Oxjade/Circuit/README.md

# Circuit

Standalone touchscreen hardware wallet built on Ika dWallet / 2PC-MPC signing.

## Status

| Phase | State |
|---|---|
| 1 — Hardware architecture | Draft for review: [docs/phase1/hardware-architecture.md](docs/phase1/hardware-architecture.md), [placement concept](docs/phase1/placement-concept.svg) |
| 2 — Industrial design | First-pass FreeCAD model, 60 x 94 x 12.3 mm, no interferences: [mechanical/README.md](mechanical/README.md) |
| 3 — Component selection | MCU decided: STM32U5G9 (hybrid architecture accepted). Other parts proposed, pending datasheet verification |
| 4 — Electrical | Complete draft schematic, nine sheets, 127 parts: [kicad/README.md](kicad/README.md). Not reviewed; ten open items listed there |
| 5 — PCB | Provisional board outline only. No placement, no routing |
| 6–8 | Not started |

## Open gates

- **G1 (no longer blocking):** measure Ika user-side ECDSA sign on the STM32U5G9 dev kit. Decides whether the ECDSA user share can later move onto the device.
- **Datasheet pass:** component figures in Phase 1 came from search extracts, not from opened datasheets.
