Oxjade/Circuit/kicad/board-definition-preview.png

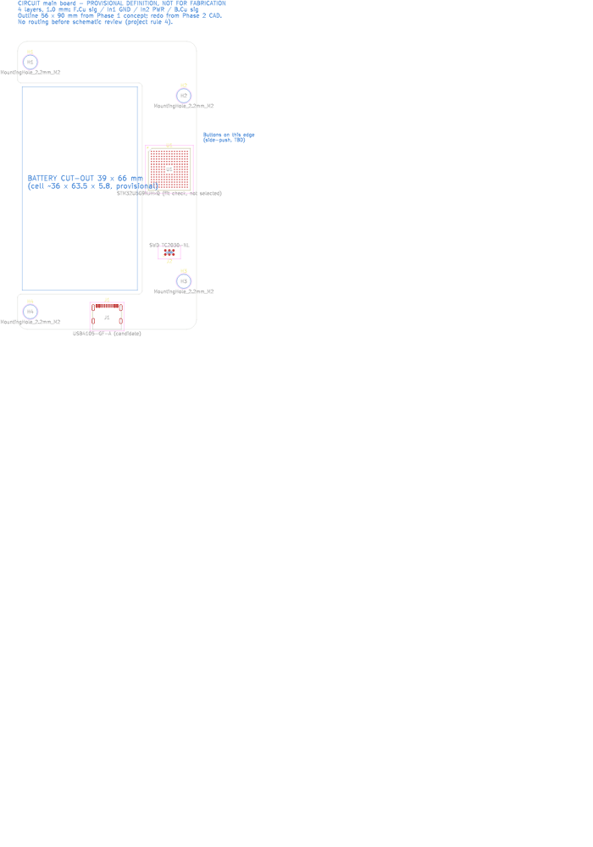
kicad/board-definition-preview.png
