Oxjade/Circuit/mechanical/renders/bottom-usb.png

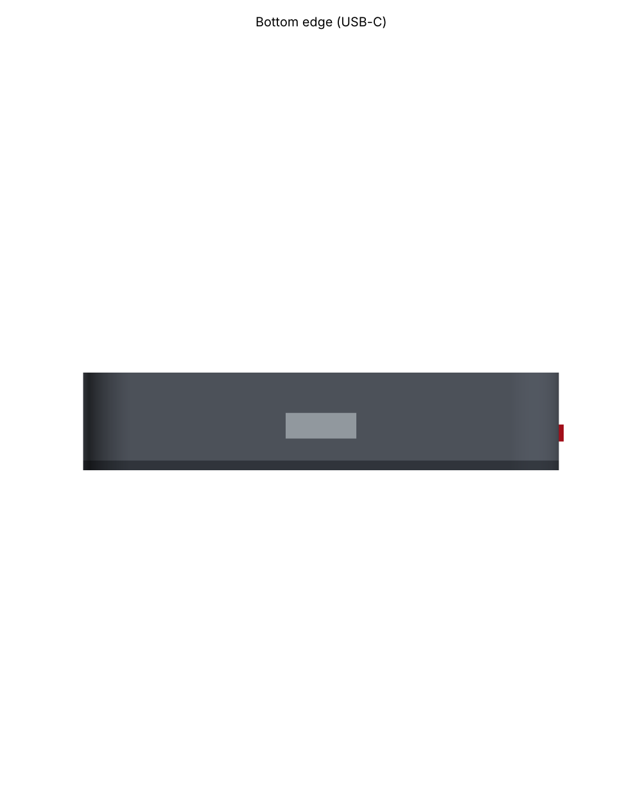
mechanical/renders/bottom-usb.png
