Oxjade/Circuit/mechanical/renders/exploded.png

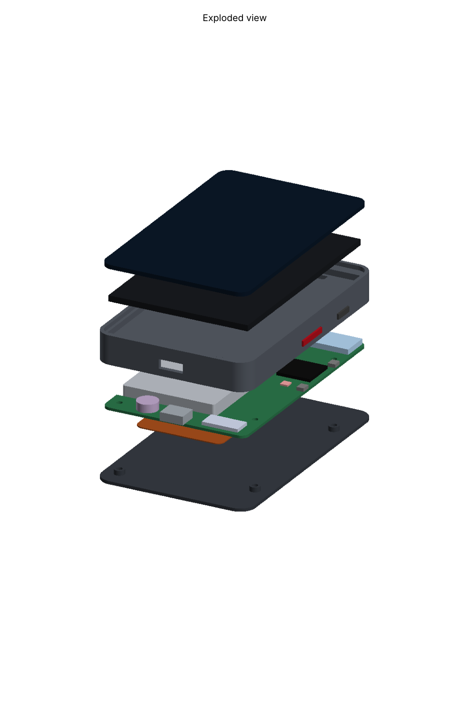
mechanical/renders/exploded.png
