Oxjade/Circuit/mechanical/renders/front-iso.png

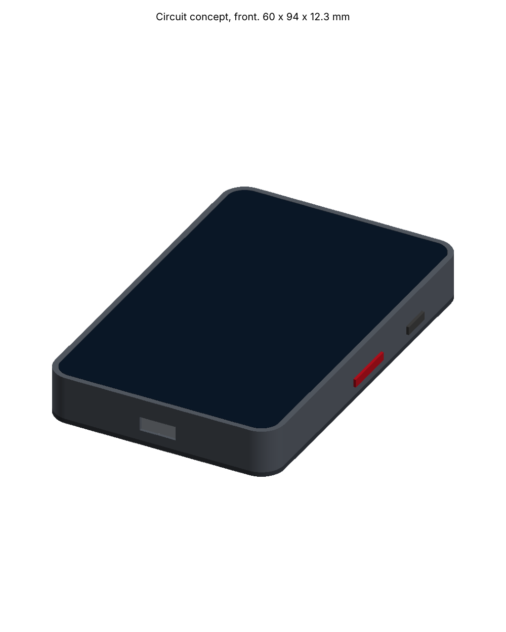
mechanical/renders/front-iso.png
