Oxjade/Circuit/mechanical/renders/front.png

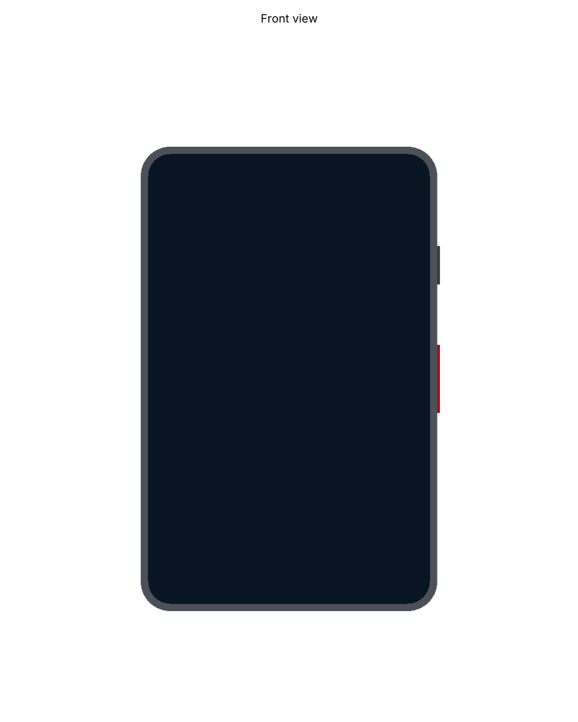
mechanical/renders/front.png
