Oxjade/Circuit/mechanical/renders/internal-from-front.png

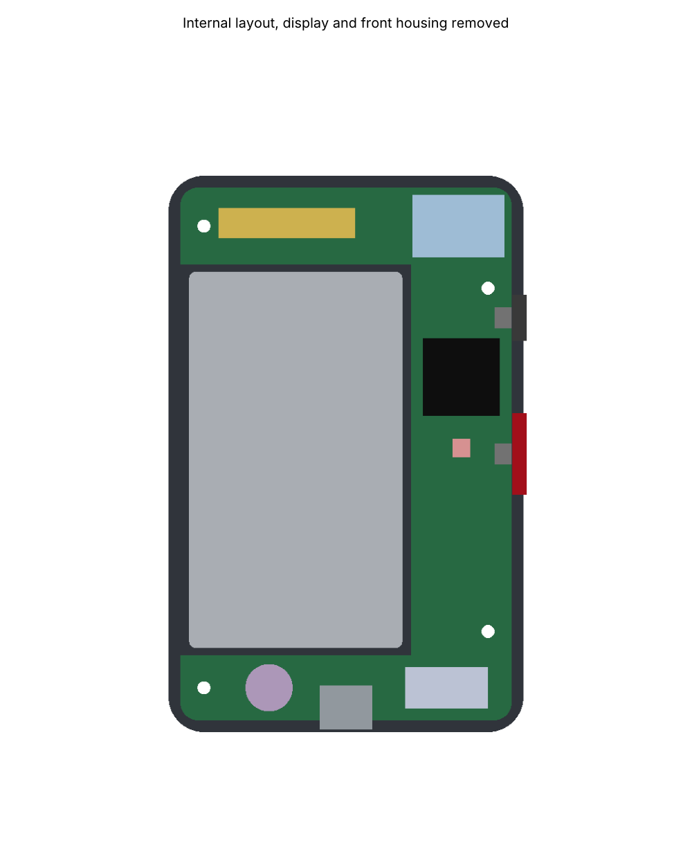
mechanical/renders/internal-from-front.png
