Oxjade/Circuit/mechanical/renders/rear-iso.png

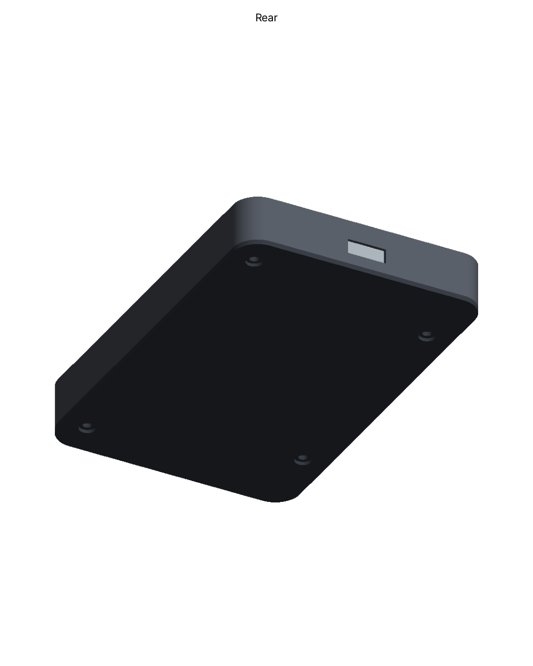
mechanical/renders/rear-iso.png
