Oxjade/Circuit/mechanical/renders/right-buttons.png

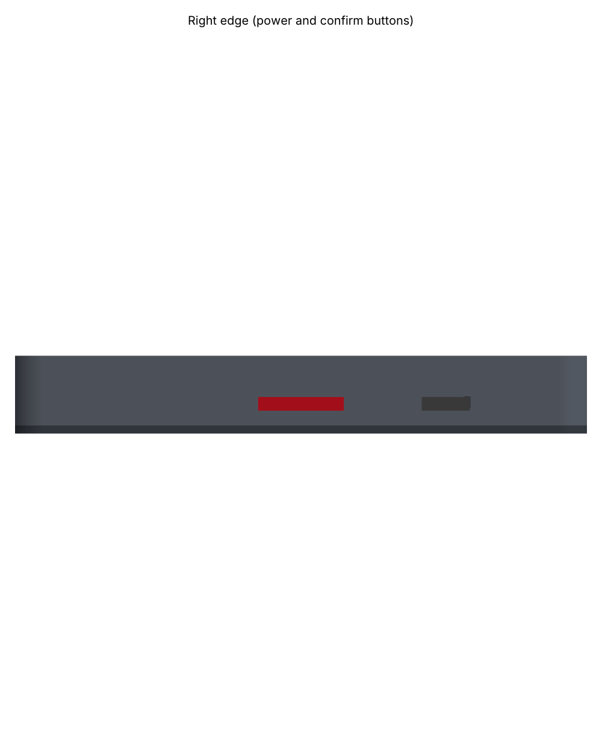
mechanical/renders/right-buttons.png
