Oxjade/Circuit/kicad/bom-draft.csv

Qty | References | Value | Footprint
2 | C1 C40 | 1uF 25V | Capacitor_SMD:C_0603_1608Metric
7 | C2 C3 C35 C48 C50 C58 C61 | 1uF | Capacitor_SMD:C_0402_1005Metric
24 | C4 C5 C10 C11 C12 C13 C14 C15 C16 C17 C18 C19 C24 C25 C26 C28 C36 C37 C38 C43 C51 C52 C54 C57 | 100nF | Capacitor_SMD:C_0402_1005Metric
4 | C20 C21 C22 C34 | 2.2uF (TBD) | Capacitor_SMD:C_0402_1005Metric
6 | C23 C27 C44 C45 C46 C53 | 10uF | Capacitor_SMD:C_0603_1608Metric
1 | C29 | 100nF (TBD) | Capacitor_SMD:C_0402_1005Metric
4 | C30 C31 C32 C33 | CL (TBD) | Capacitor_SMD:C_0402_1005Metric
3 | C41 C42 C55 | 4.7uF | Capacitor_SMD:C_0603_1608Metric
2 | C47 C49 | 1nF (TBD) | Capacitor_SMD:C_0402_1005Metric
1 | C56 | DNP (tune) | Capacitor_SMD:C_0402_1005Metric
1 | C59 | 1uF 50V | Capacitor_SMD:C_0603_1608Metric
1 | C60 | 220nF | Capacitor_SMD:C_0402_1005Metric
2 | D1 D2 | ESD 0402 (TBD)
1 | D3 | 40V 0.5A | Diode_SMD:D_SOD-123
1 | FB1 | 600R@100MHz | Inductor_SMD:L_0402_1005Metric
1 | J1 | USB4105-GF-A (candidate) | Connector_USB:USB_C_Receptacle_GCT_USB4105-xx-A_16P_TopMnt_Horizontal
1 | J2 | SWD TC2030-NL | Connector:Tag-Connect_TC2030-IDC-NL_2x03_P1.27mm_Vertical
1 | J3 | LRA pads
1 | J4 | Li-Po JST-PH | Connector_JST:JST_PH_S2B-PH-SM4-TB_1x02-1MP_P2.00mm_Horizontal
1 | J5 | BLE SWD TC2030-NL | Connector:Tag-Connect_TC2030-IDC-NL_2x03_P1.27mm_Vertical
1 | J6 | NFC coil pads
1 | J7 | LCD FPC 40P 0.5mm (PINOUT TBD) | Connector_FFC-FPC:Hirose_FH12-40S-0.5SH_1x40-1MP_P0.50mm_Horizontal
1 | J8 | Touch FPC 6P 0.5mm (PINOUT TBD) | Connector_FFC-FPC:Hirose_FH12-6S-0.5SH_1x06-1MP_P0.50mm_Horizontal
2 | J9 J10 | case switch pads
1 | L1 | 2.2uH (TBD) | Inductor_SMD:L_0805_2012Metric
1 | L2 | 2.2uH 1.5A | Inductor_SMD:L_1008_2520Metric
1 | L3 | 10uH 0.5A | Inductor_SMD:L_1008_2520Metric
2 | R1 R2 | 5.1k 1% | Resistor_SMD:R_0402_1005Metric
1 | R3 | 0R (TBD) | Resistor_SMD:R_0402_1005Metric
11 | R4 R5 R8 R34 R35 R36 R37 R39 R40 R45 R47 | 100k | Resistor_SMD:R_0402_1005Metric
2 | R6 R9 | 1k | Resistor_SMD:R_0402_1005Metric
2 | R10 R11 | 1M | Resistor_SMD:R_0402_1005Metric
1 | R20 | 0R (TBD, see note 2) | Resistor_SMD:R_0402_1005Metric
2 | R21 R33 | 0R | Resistor_SMD:R_0402_1005Metric
5 | R22 R43 R44 R48 R49 | 10k | Resistor_SMD:R_0402_1005Metric
6 | R23 R24 R25 R26 R27 R28 | 2.2k | Resistor_SMD:R_0402_1005Metric
1 | R30 | 1.78k 1% | Resistor_SMD:R_0402_1005Metric
1 | R31 | 1.6k 1% | Resistor_SMD:R_0402_1005Metric
1 | R32 | 10k 1% | Resistor_SMD:R_0402_1005Metric
1 | R38 | 100R | Resistor_SMD:R_0402_1005Metric
2 | R41 R42 | 1M 1% | Resistor_SMD:R_0402_1005Metric
1 | R46 | 10R 1% | Resistor_SMD:R_0402_1005Metric
1 | SW1 | CONFIRM
1 | SW2 | POWER
1 | U1 | STM32U5G9NJH6Q | Package_BGA:TFBGA-216_13x13mm_Layout15x15_P0.8mm
1 | U2 | USBLC6-2SC6 | Package_TO_SOT_SMD:SOT-23-6
1 | U3 | DRV2605LDGS | Package_SO:VSSOP-10_3x3mm_P0.5mm
1 | U4 | BQ24075RGT | Package_DFN_QFN:VQFN-16-1EP_3x3mm_P0.5mm_EP1.6x1.6mm
1 | U5 | TPS63001 | Package_SON:Texas_DRC0010J_ThermalVias
2 | U6 U7 | TPS22917DBV | Package_TO_SOT_SMD:SOT-23-6
1 | U8 | OPTIGA Trust M V3 | Package_DFN_QFN:DFN-10-1EP_3x3mm_P0.5mm_EP1.55x2.48mm
1 | U9 | MDBT50Q-1MV2 | RF_Module:Raytac_MDBT50Q
1 | U10 | ST25DV04K-IER8C3 | Package_DFN_QFN:DFN-8-1EP_3x2mm_P0.5mm_EP1.36x1.46mm
1 | U11 | TPS61165DBV | Package_TO_SOT_SMD:SOT-23-6
1 | Y1 | 16MHz | Crystal:Crystal_SMD_2016-4Pin_2.0x1.6mm
1 | Y2 | 32.768kHz | Crystal:Crystal_SMD_3215-2Pin_3.2x1.5mm
