Oxjade/Circuit/mechanical/circuit-assembly.step

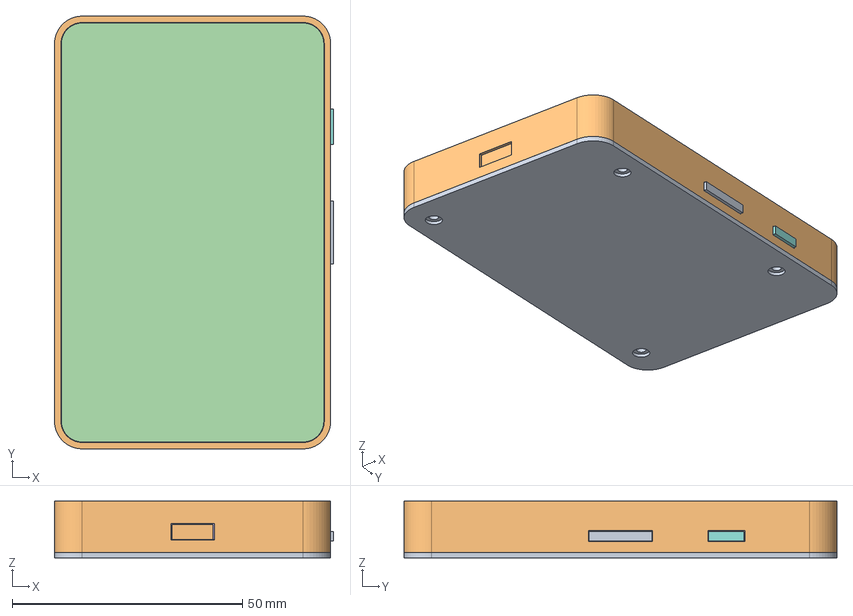
[picture p9: CAD file, 2026-11-11]
mechanical/circuit-assembly.step
60.6 x 94.0 x 12.3 mm
