Oxjade/Circuit/mechanical/rear_cover.stl

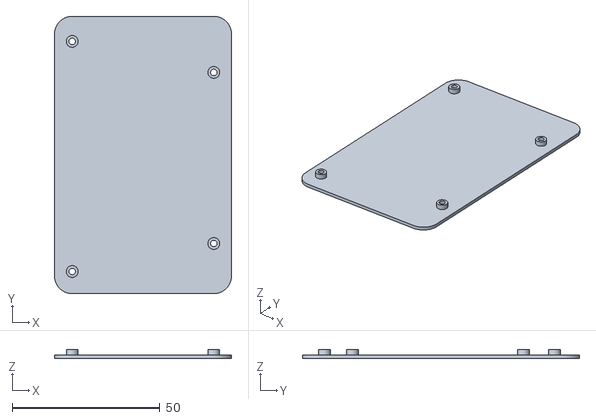
[picture p10: CAD file, 2026-11-11]
mechanical/rear_cover.stl
60.0 x 94.0 x 3.00
