Oxjade/Circuit/mechanical/button_power.stl

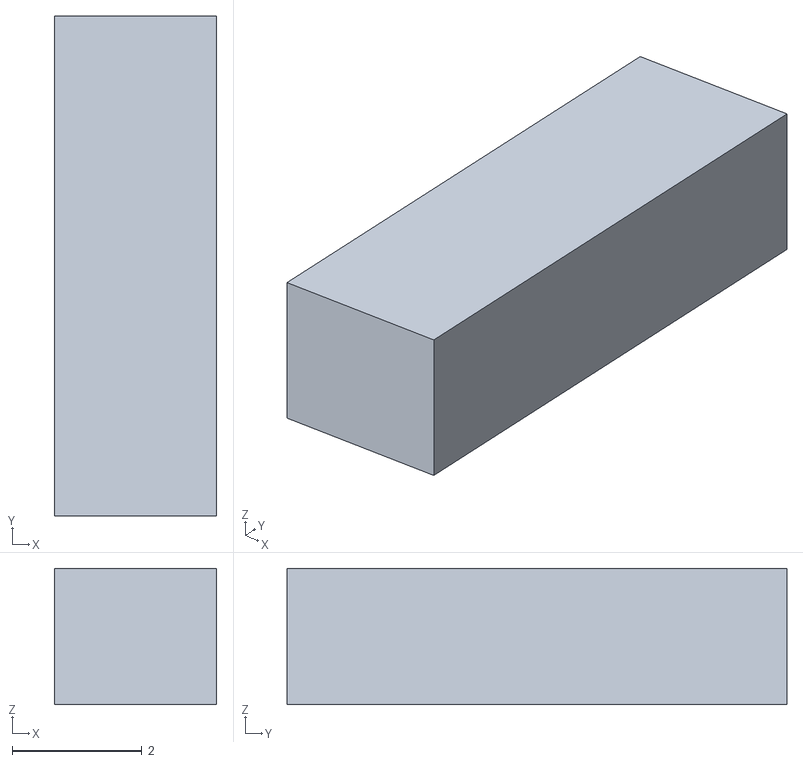
[picture p11: CAD file, 2026-11-11]
mechanical/button_power.stl
2.50 x 7.70 x 2.10
