Oxjade/Circuit/mechanical/button_confirm.stl

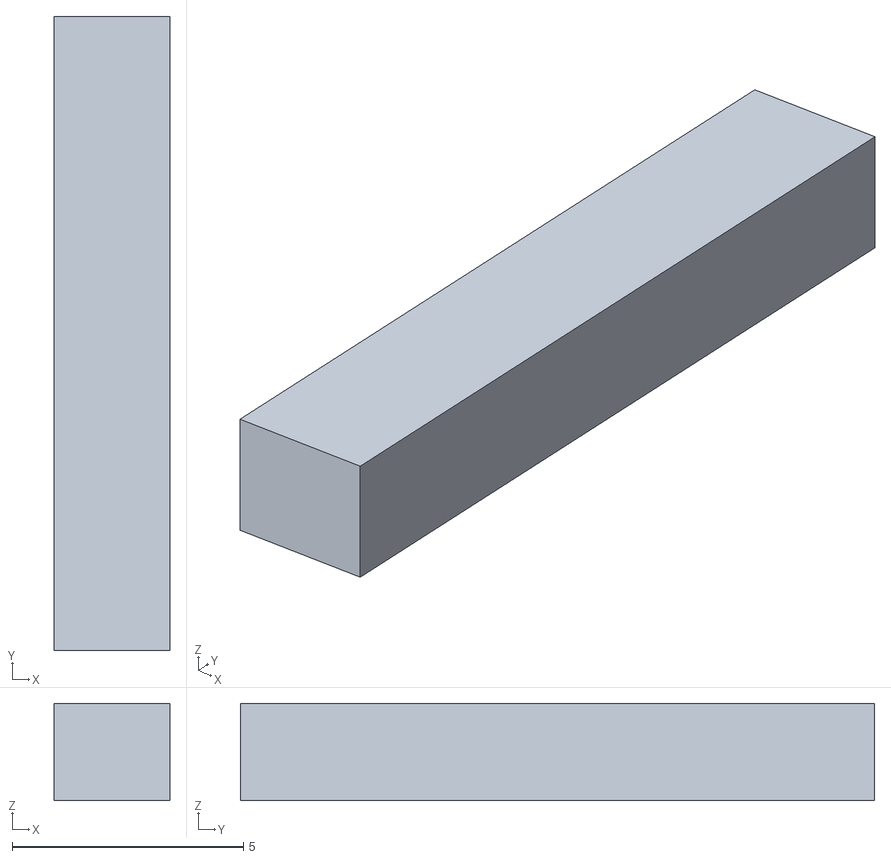
[picture p12: CAD file, 2026-11-11]
mechanical/button_confirm.stl
2.50 x 13.7 x 2.10
