Oxjade/Circuit/mechanical/front_housing.stl

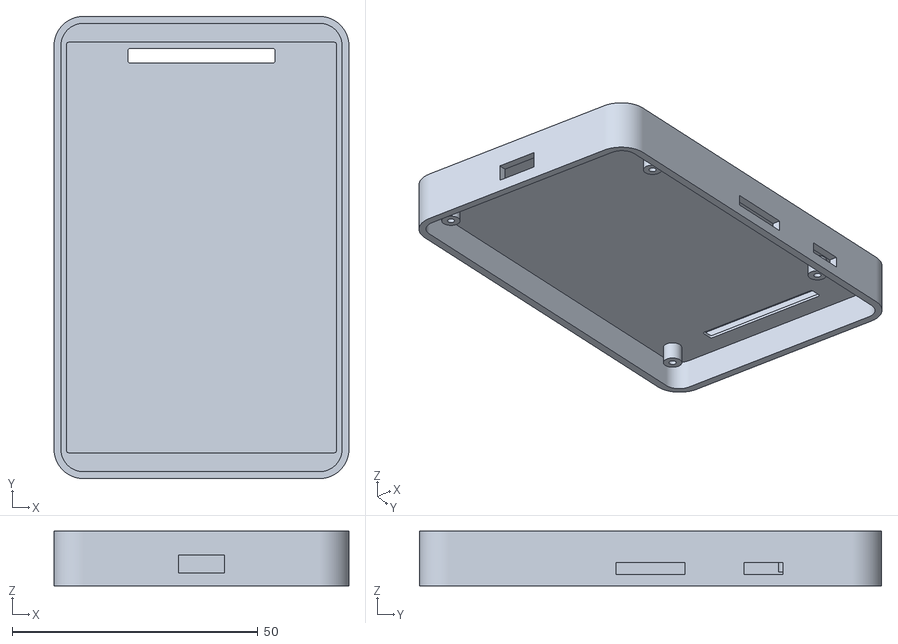
[picture p13: CAD file, 2026-11-11]
mechanical/front_housing.stl
60.0 x 94.0 x 11.1
