Oxjade/Circuit/(list of files, cad)

Other CAD files:
mechanical/circuit.FCStd
