Oxjade/Circuit/kicad/schematic-draft.pdf

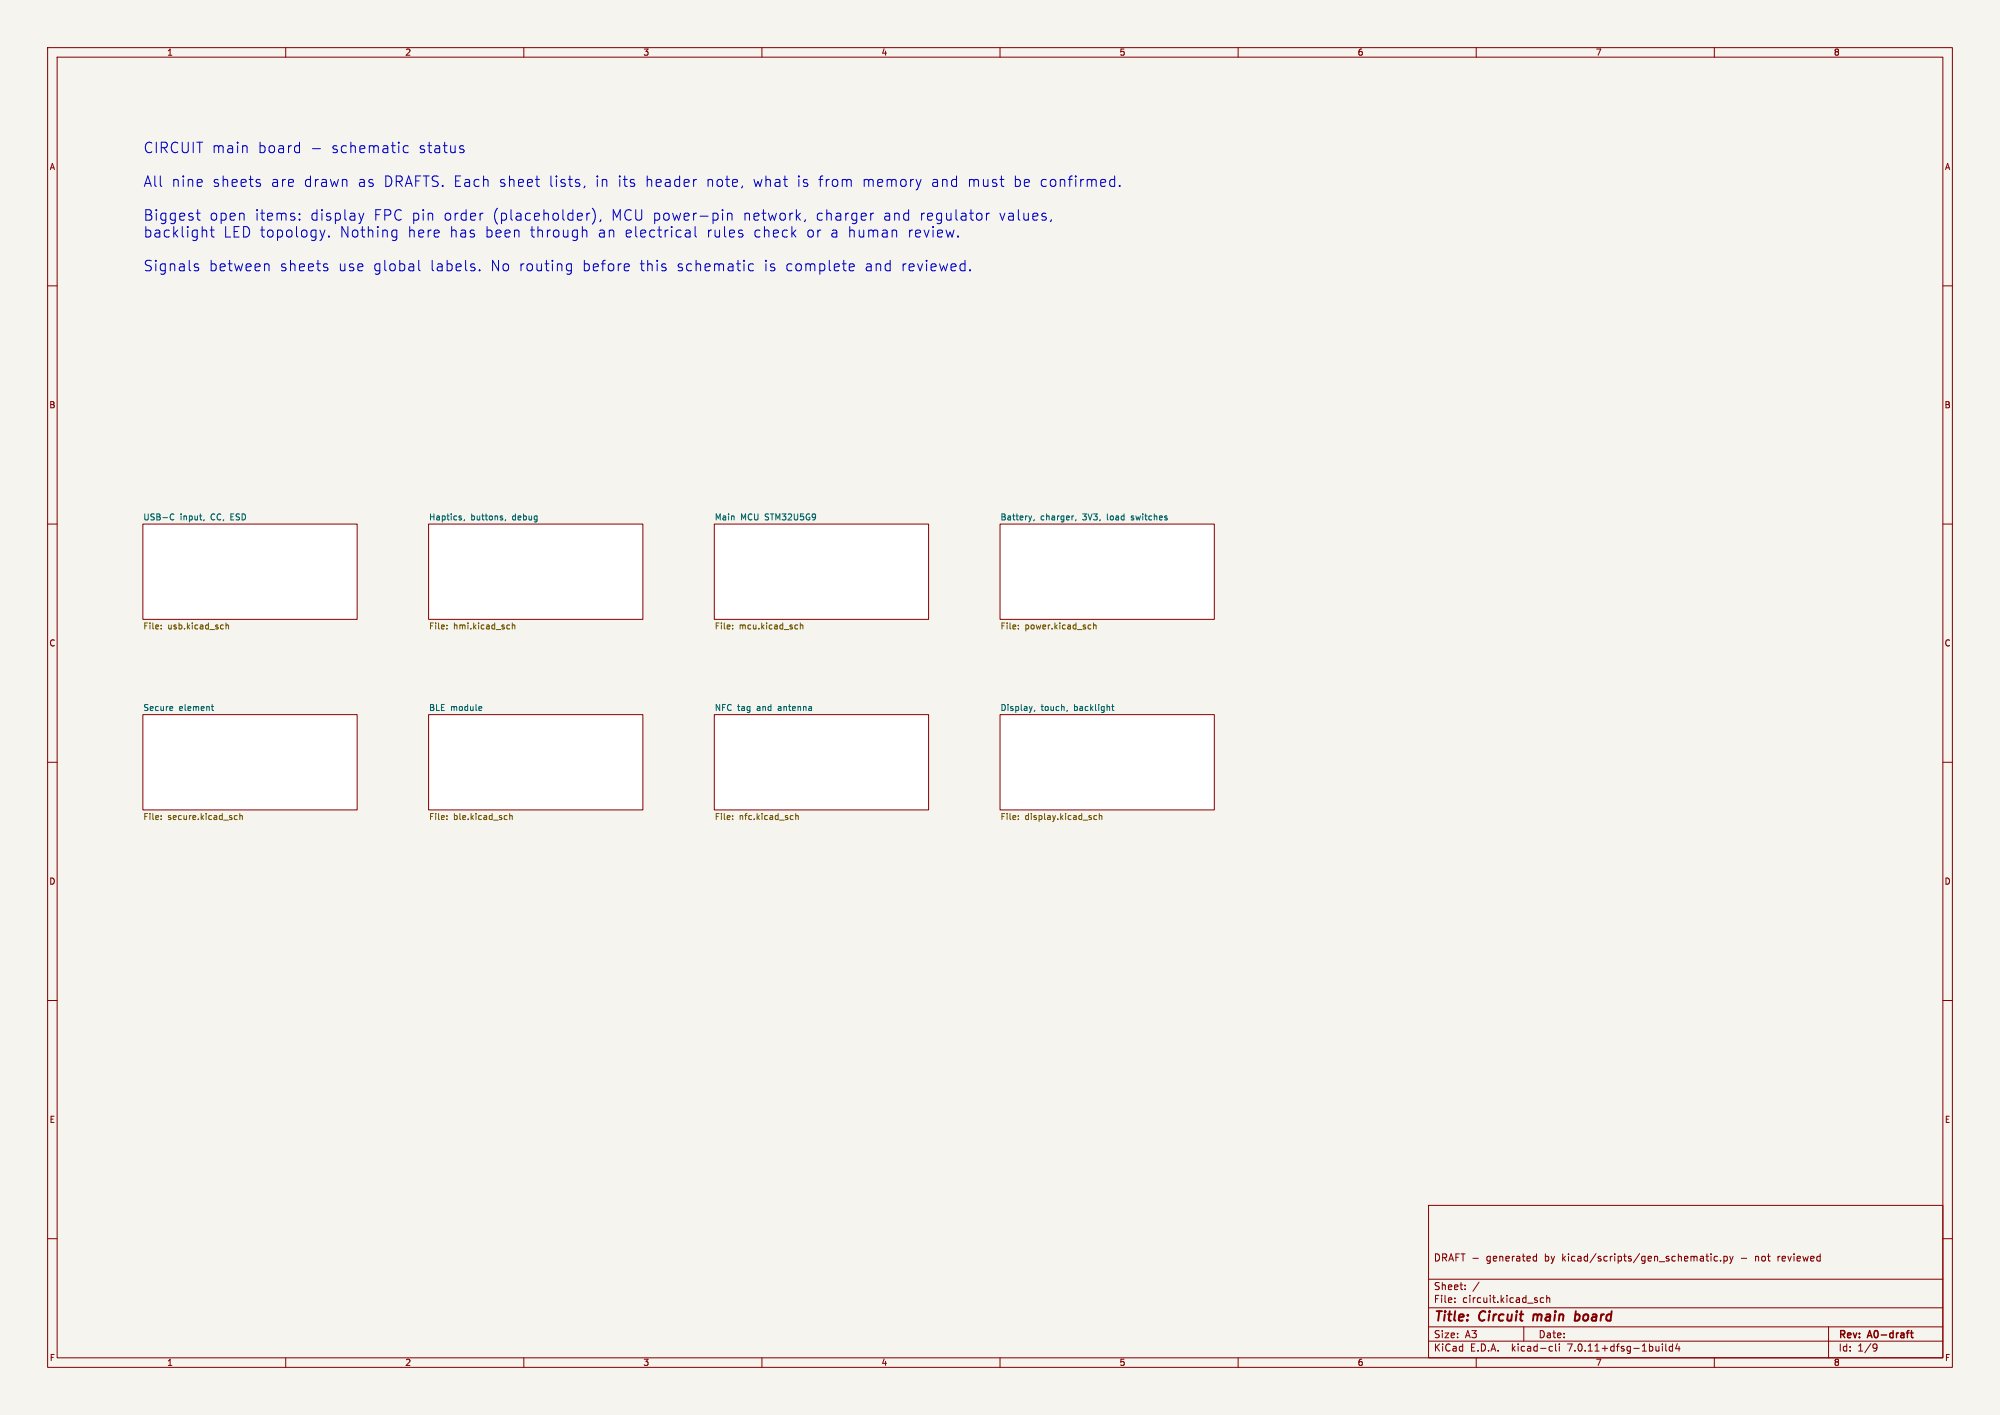
[picture p14: page 1]

Id: 1/9 Title: Circuit main board

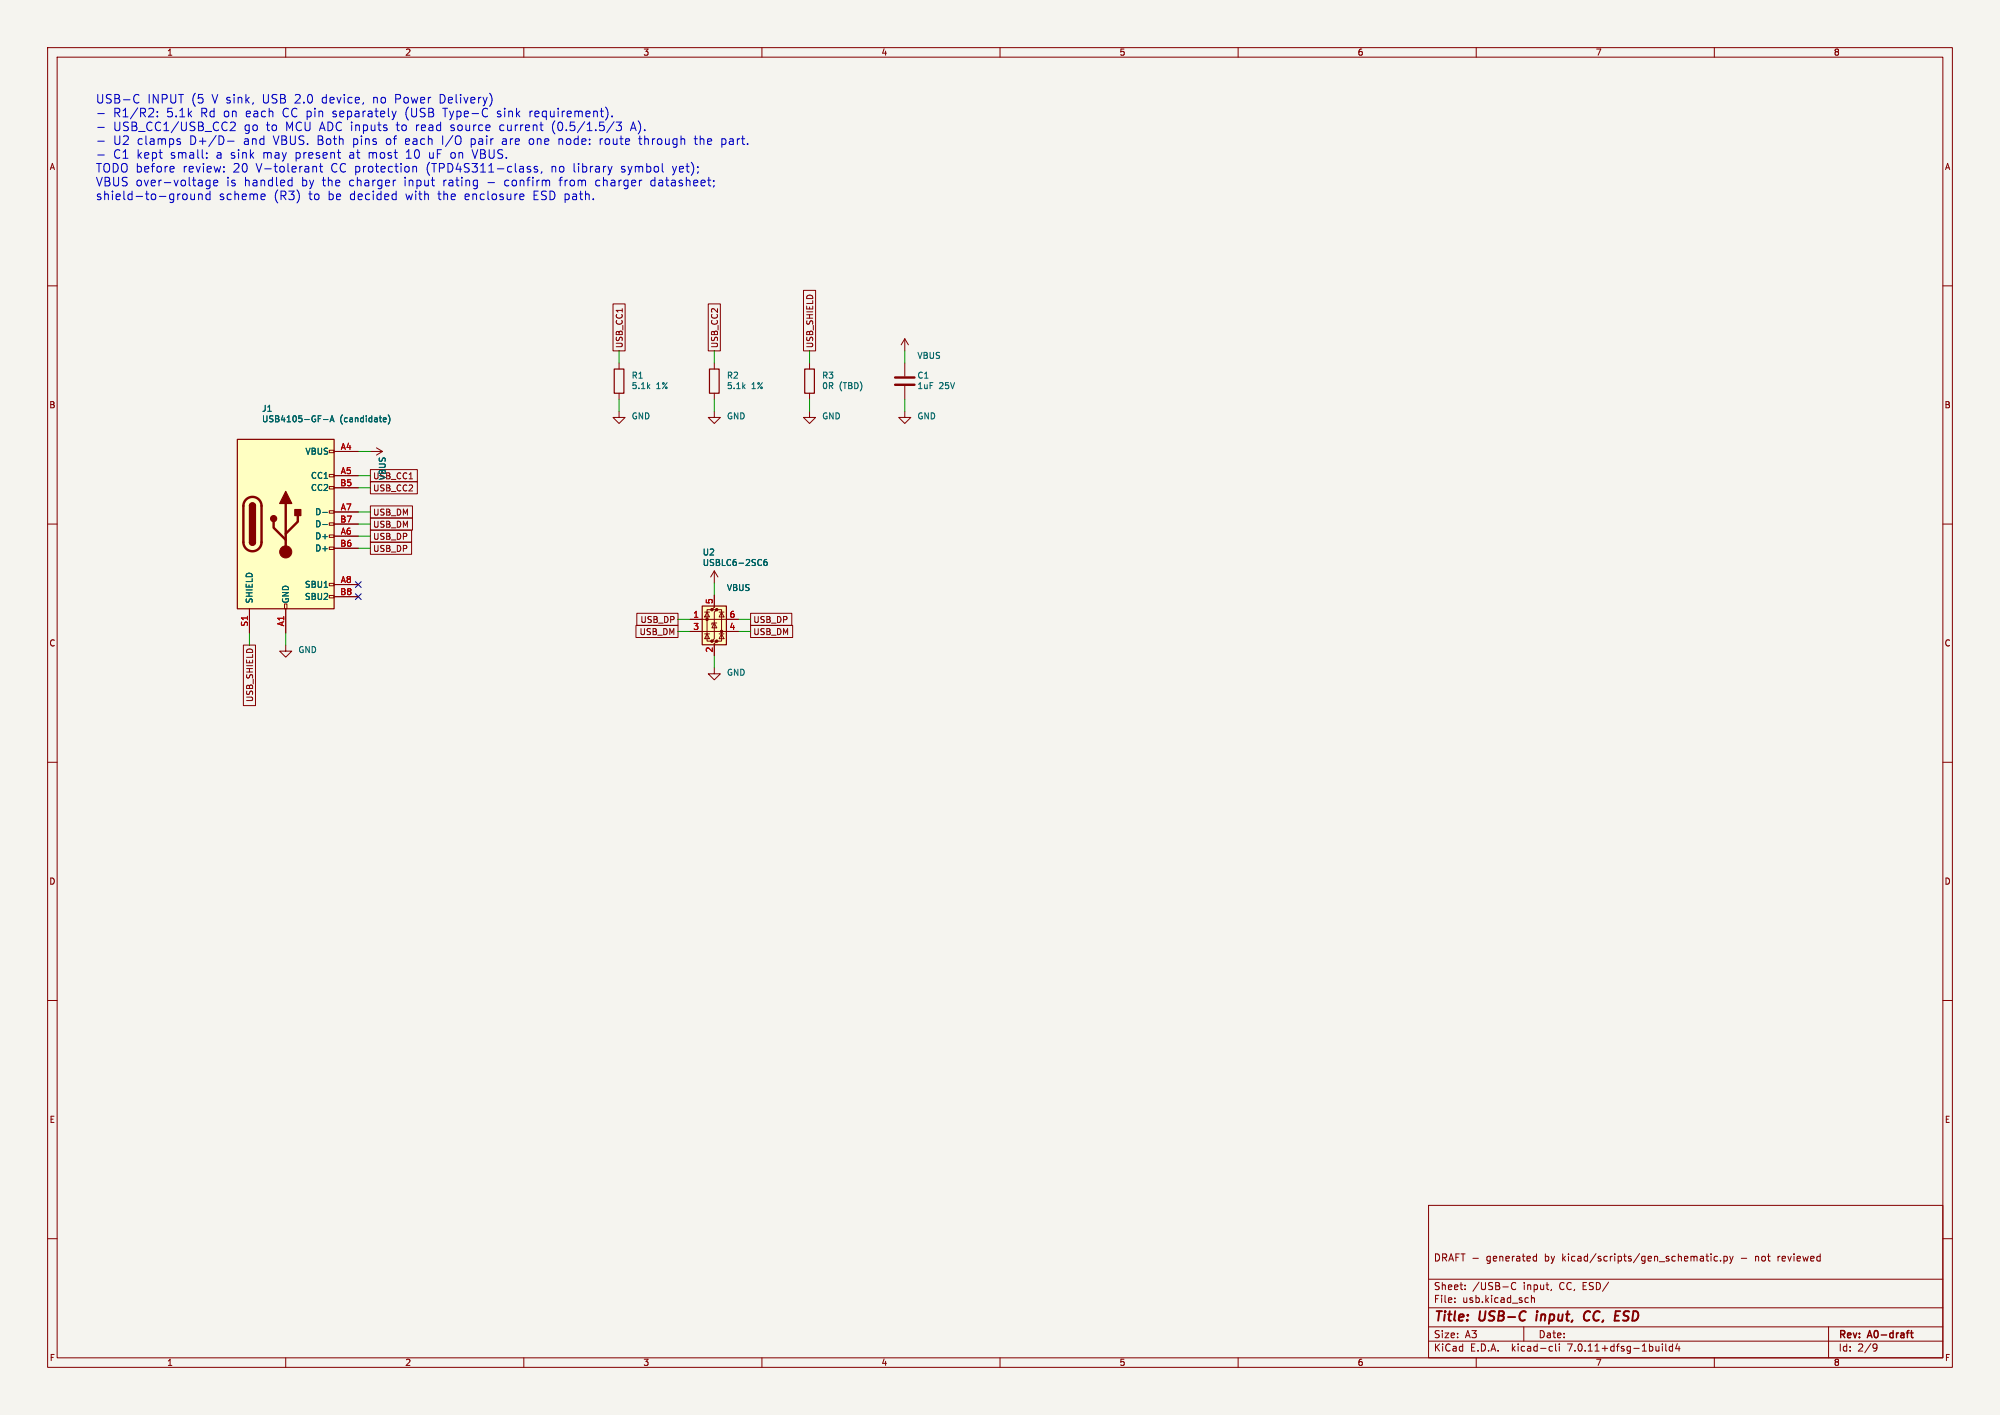
[picture p15: page 2]

Id: 2/9 Title: USB-C input, CC, ESD

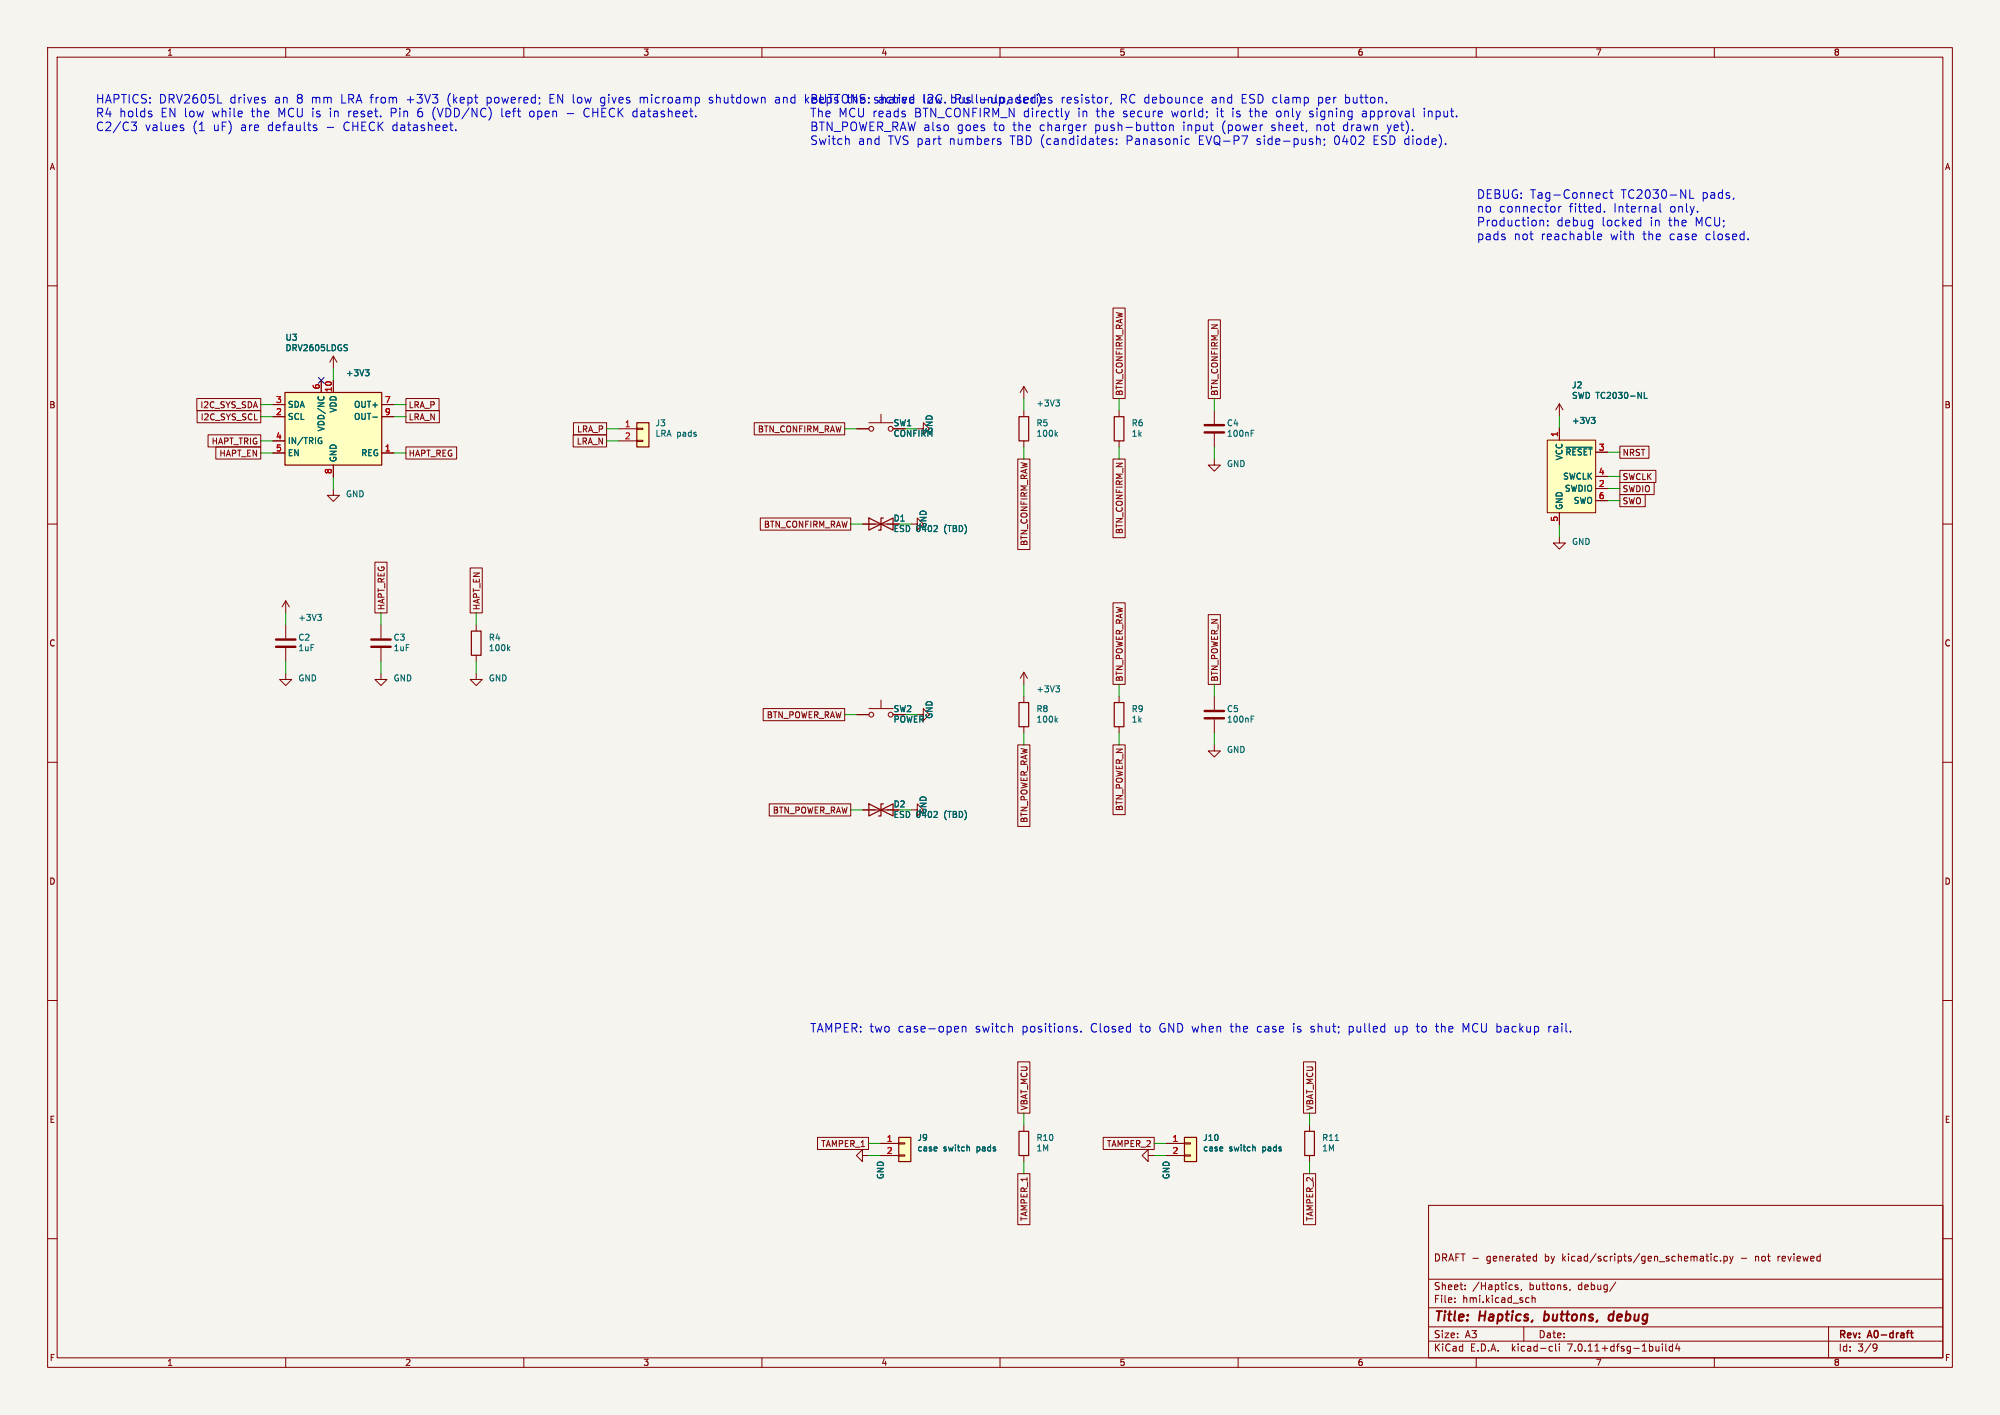
[picture p16: page 3]

R4 holds EN low while the MCU is in reset. Pin 6 (VDD/NC) left open - CHECK datasheet.

1 SWDIO 2 ~{RESET}3 SWCLK 4 GND

Id: 3/9 Title: Haptics, buttons, debug

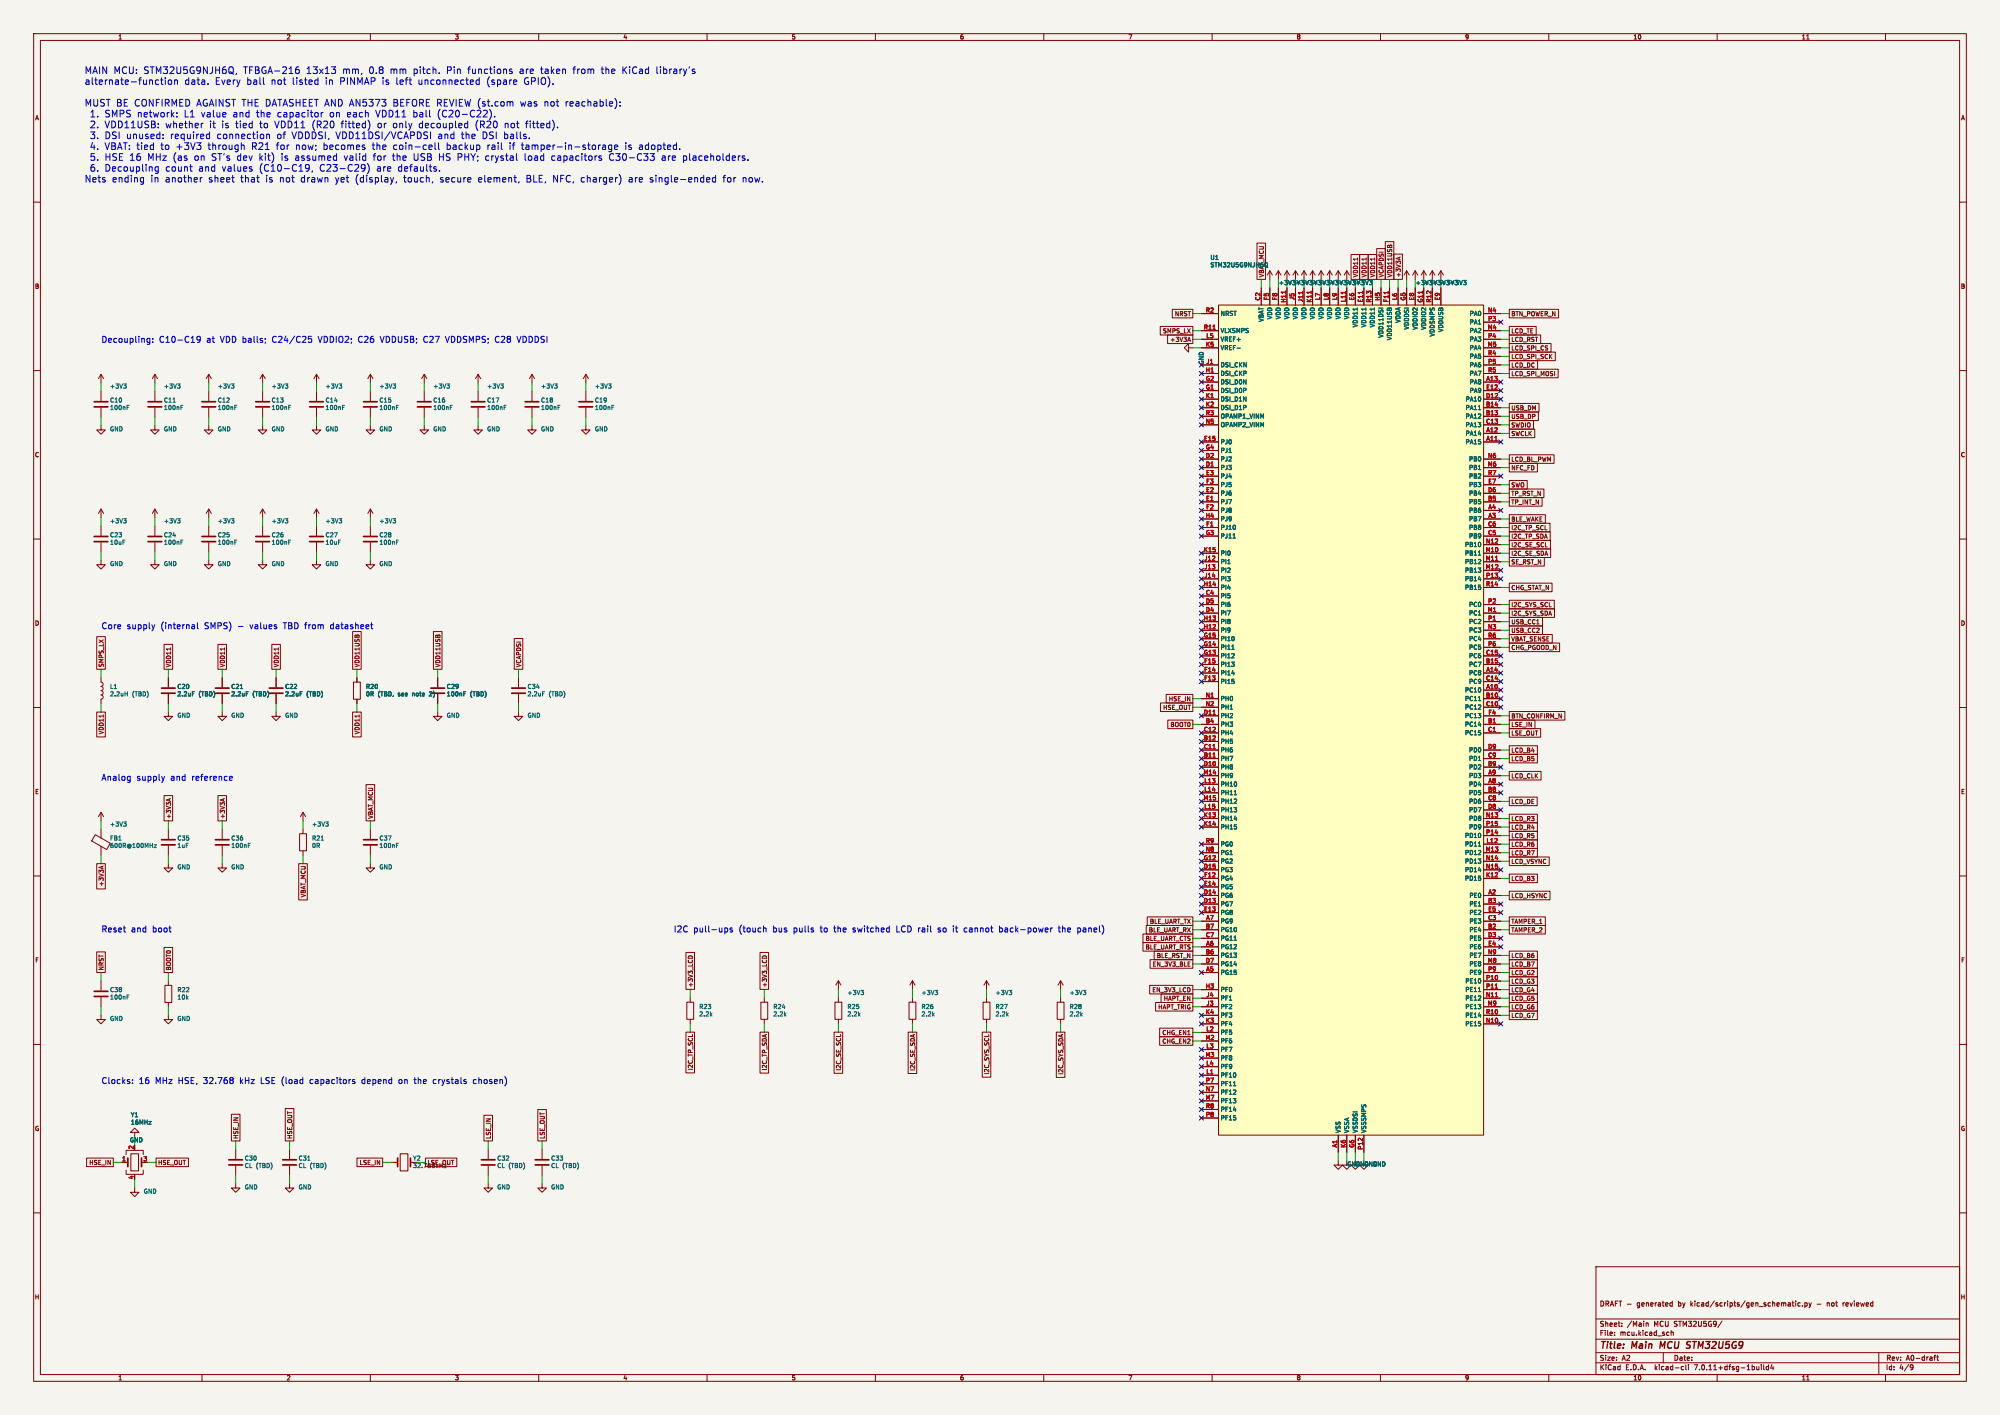
[picture p17: page 4]

MUST BE CONFIRMED AGAINST THE DATASHEET AND AN5373 BEFORE REVIEW (st.com was not reachable):

VBAT_SENSE Analog supply and reference

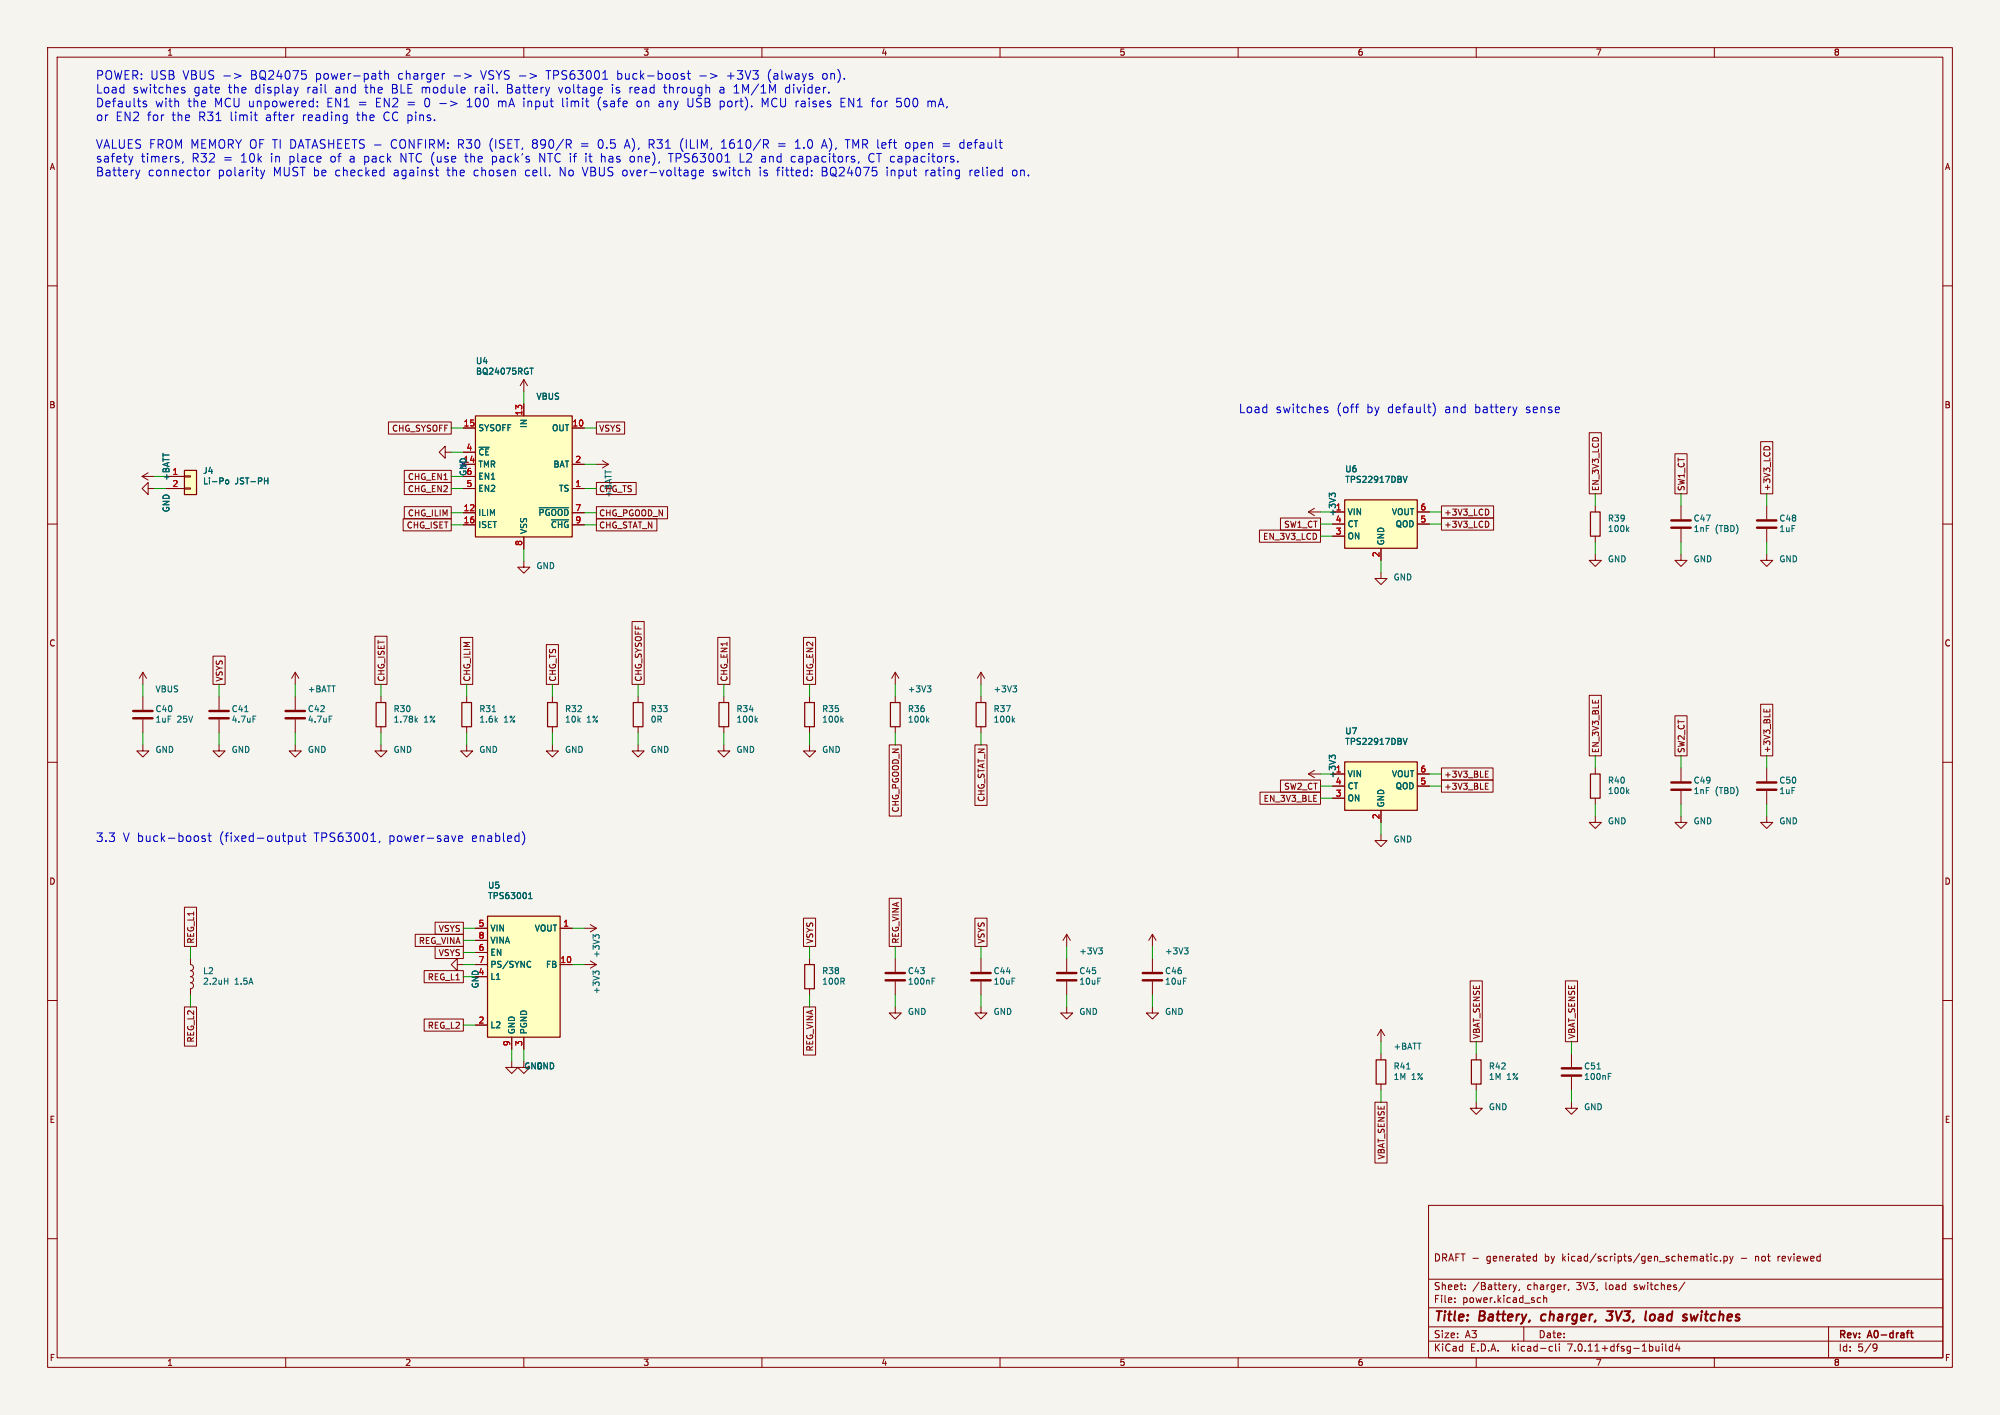
[picture p18: page 5]

Load switches gate the display rail and the BLE module rail. Battery voltage is read through a 1M/1M divider.

2 ON 3 CT 4 QOD 5 VOUT 6 U6 TPS22917DBVGND

2 ON 3 CT 4 QOD 5 VOUT 6 U7 TPS22917DBV +3V3 +3V3 VIN 1 GND

2 ON 3 CT 4 QOD 5 VOUT 6 +3V3 +3V3 U7 TPS22917DBV

2 ON 3 CT 4 QOD 5 VOUT 6

Id: 5/9 Title: Battery, charger, 3V3, load switches

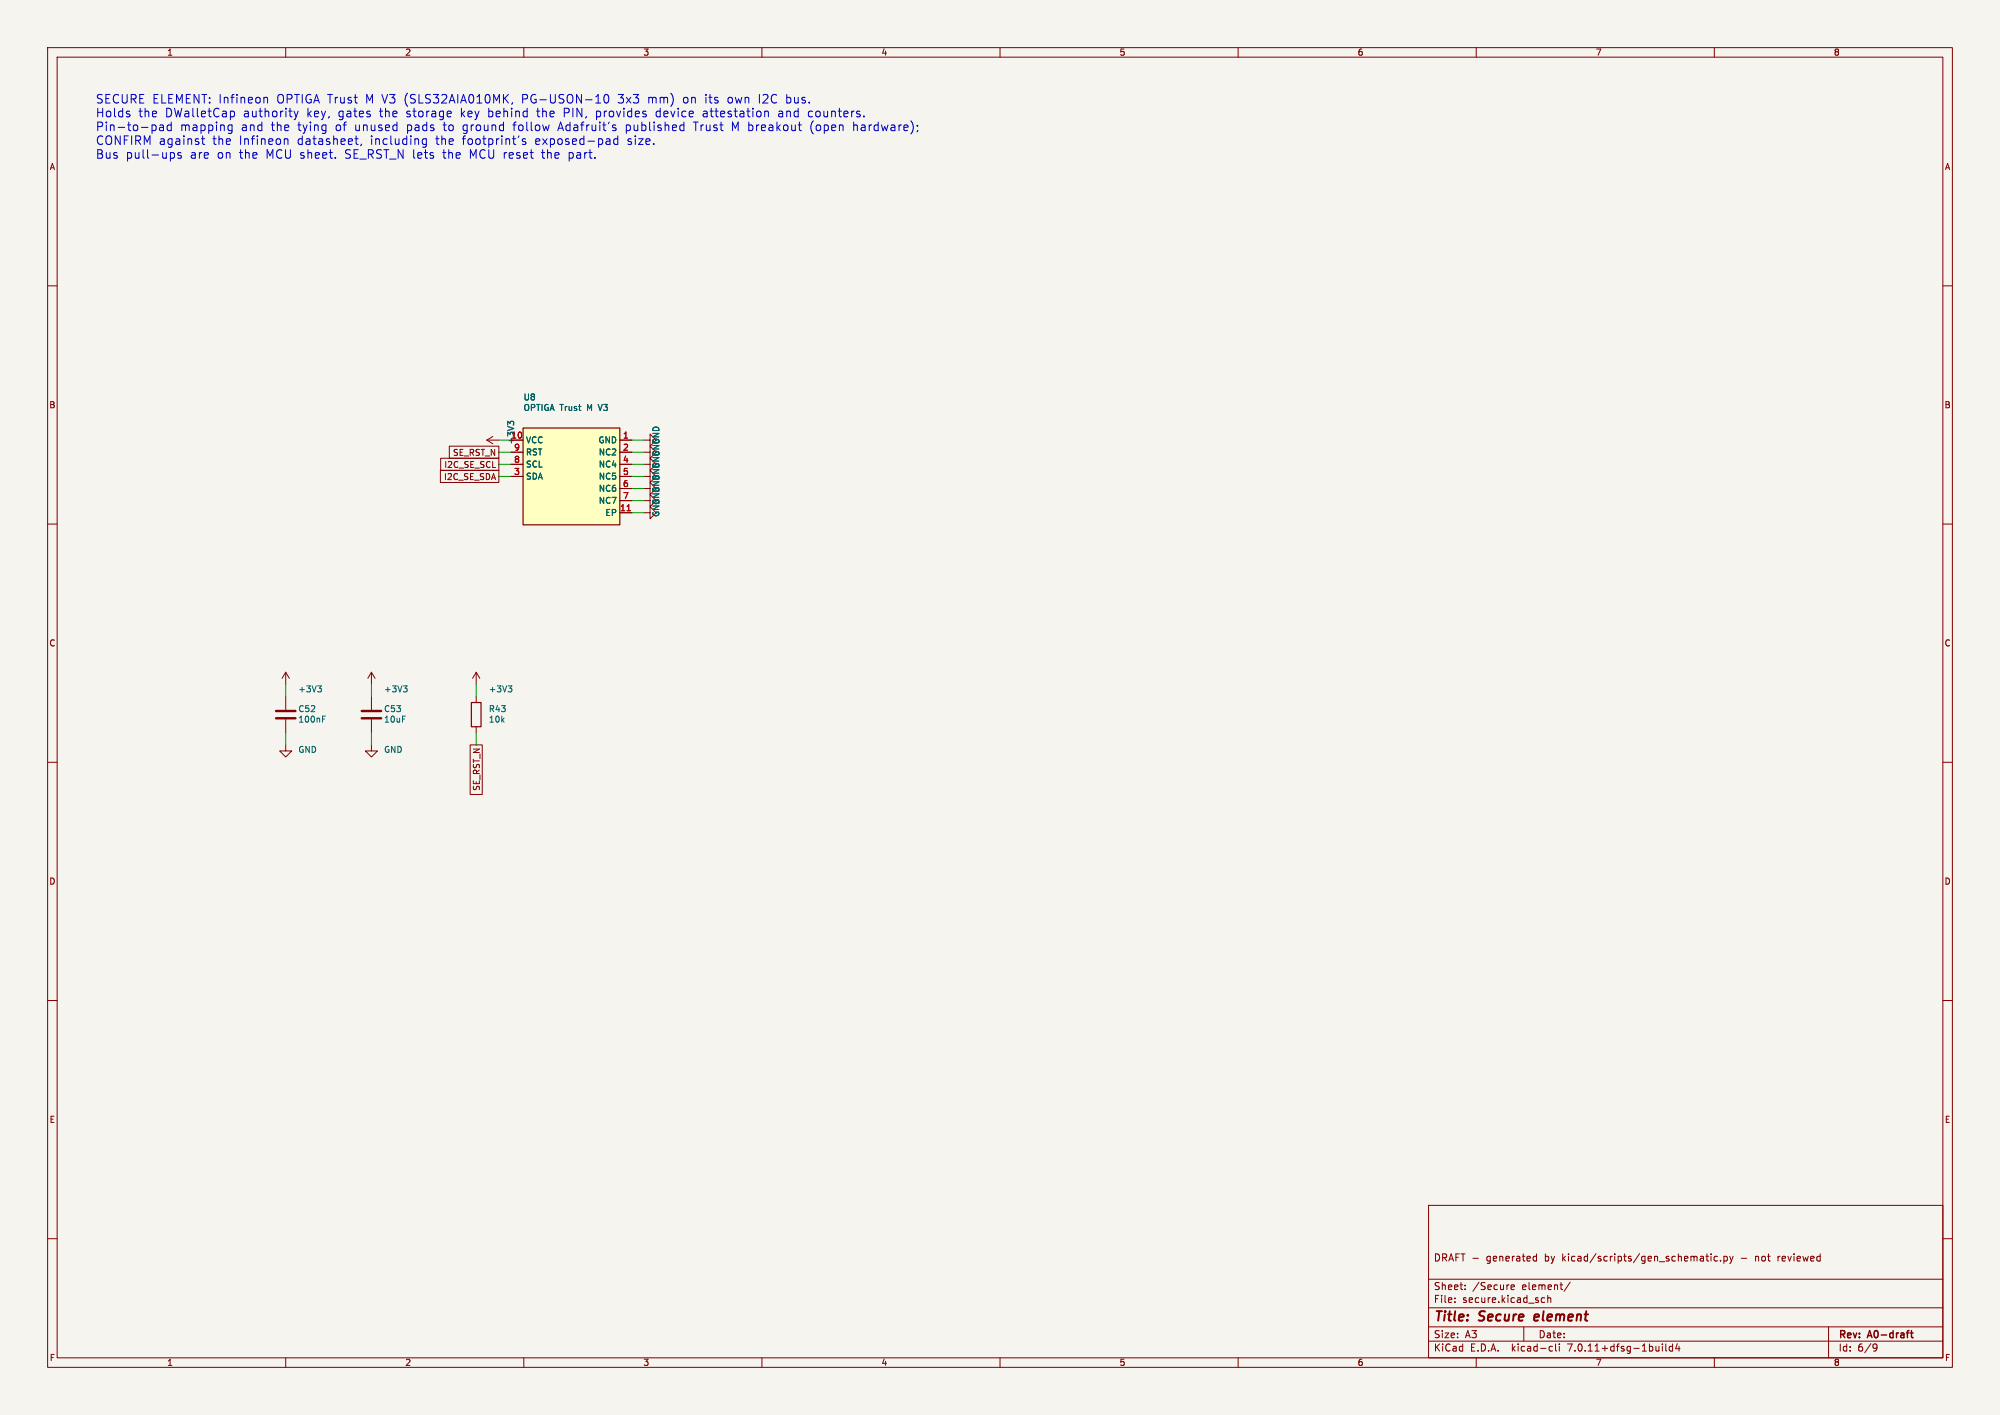
[picture p19: page 6]

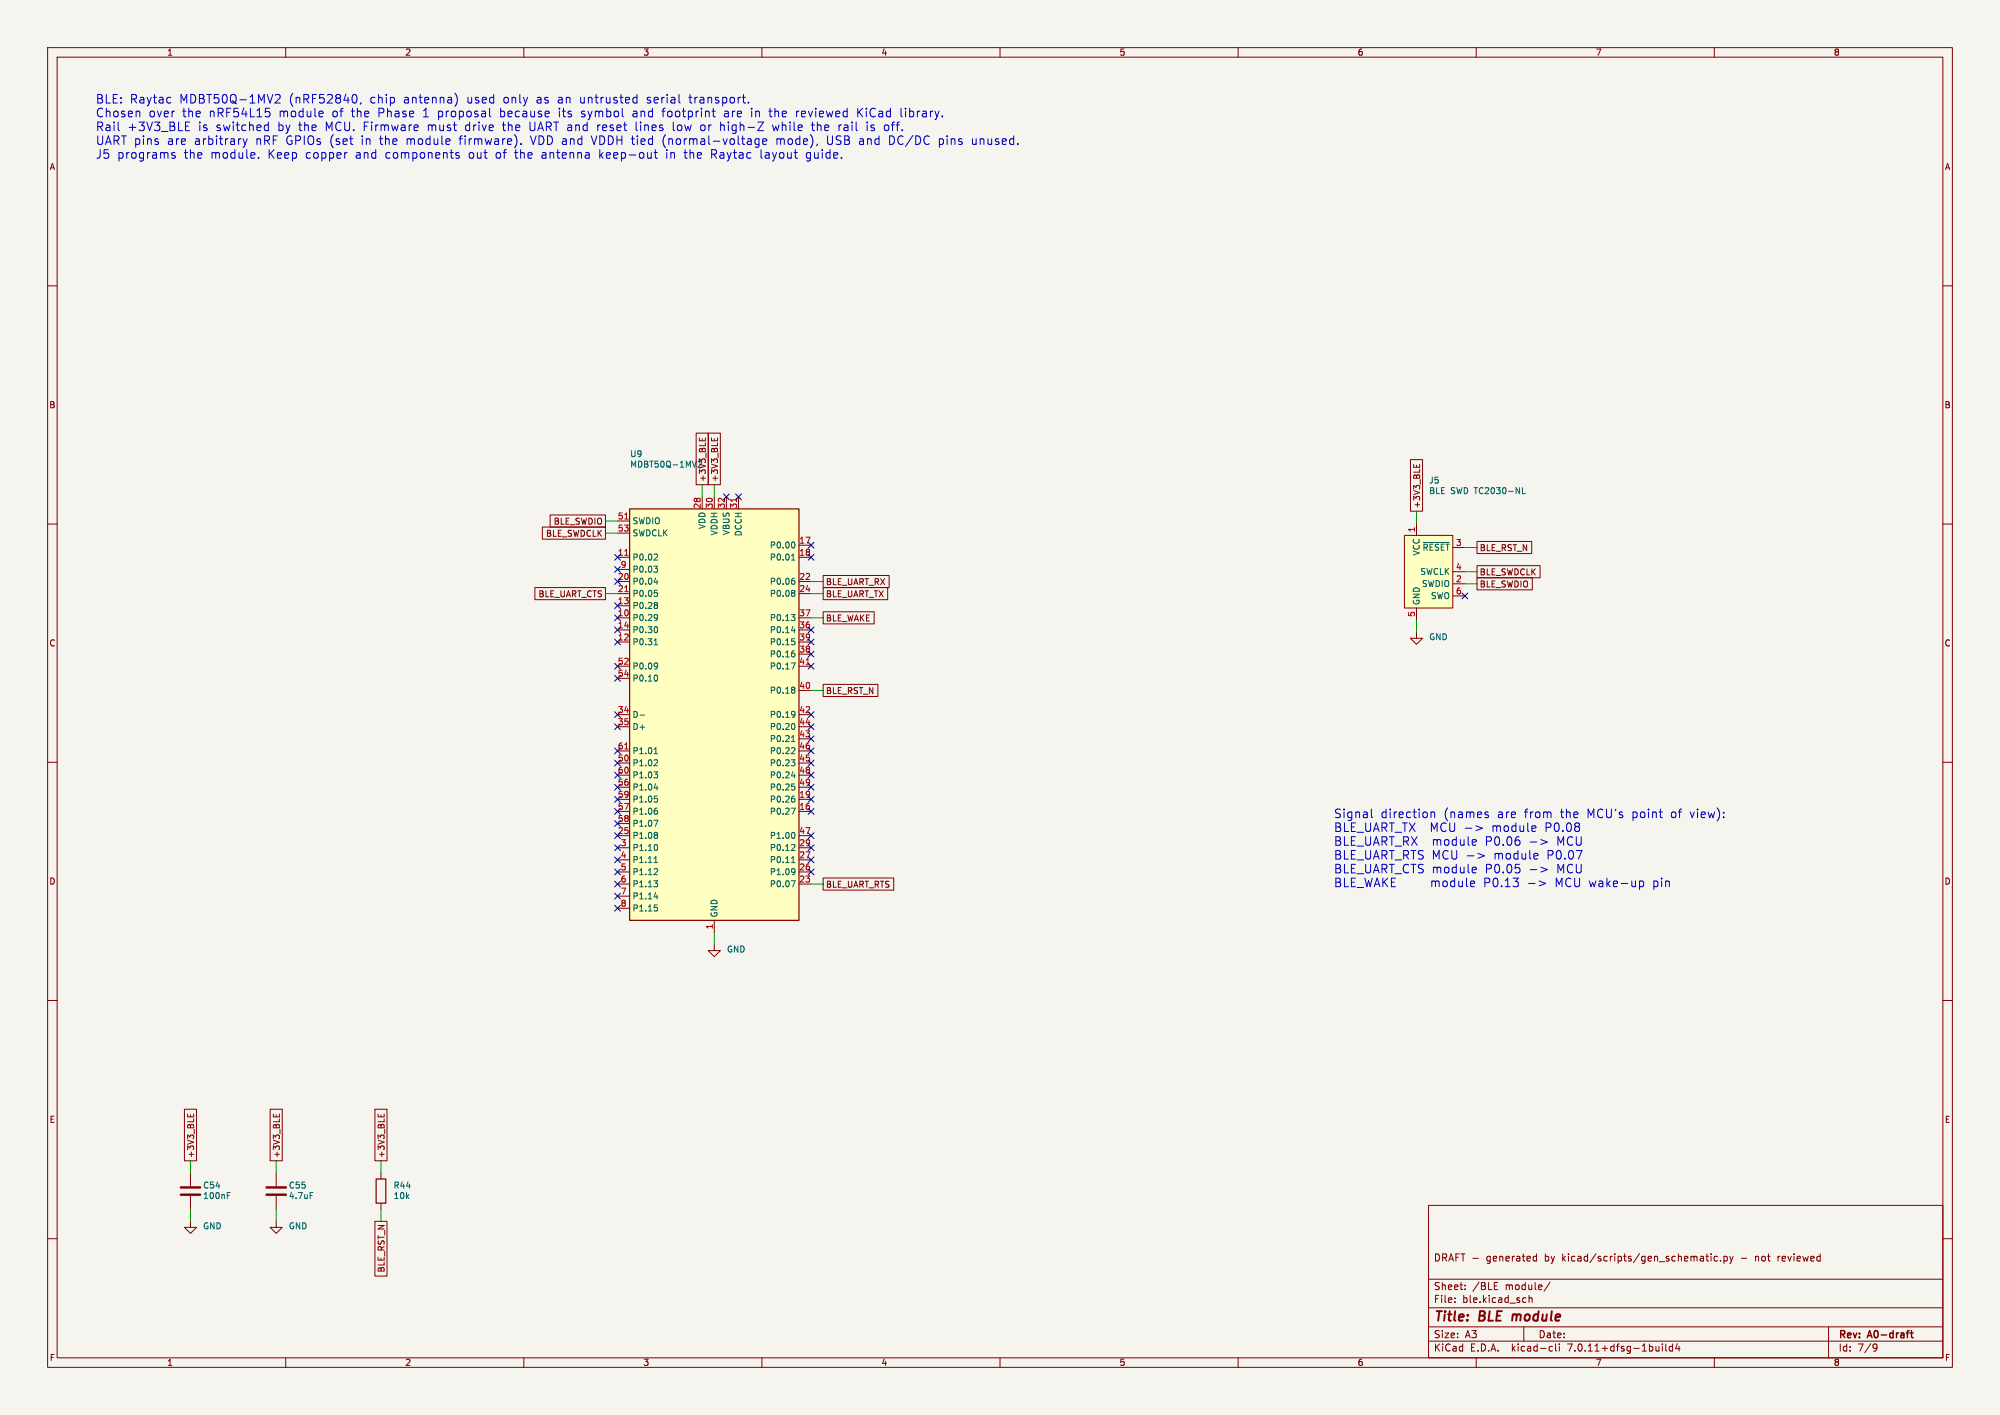
[picture p20: page 7]

1 P0.29 10 P0.02 11 P0.31 12 P0.28 13 P0.30 14 P0.27 16 P0.00 17 P0.01 18 P0.26 19 P0.04 20 P0.05 21 P0.06 22 P0.07 23 P0.08 24 P1.08 25 P1.09 26 P0.11 27 VDD 28 P0.12 29 P1.10 3 VDDH 30 DCCH 31 VBUS 32 D- 34 D+ 35 P0.14 36 P0.13 37 P0.16 38 P0.15 39 P1.11 4 P0.18 40 P0.17 41 P0.19 42 P0.21 43 P0.20 44 P0.23 45 P0.22 46 P1.00 47 P0.24 48 P0.25 49 P1.12 5 P1.02 50 SWDIO 51 P0.09 52 SWDCLK 53 P0.10 54 P1.04 56 P1.06 57 P1.07 58 P1.05 59 P1.13 6 P1.03 60 P1.01 61 P1.14 7 P1.15 8 P0.03 9 U9 MDBT50Q-1MV2 VCC

J5BLE SWD TC2030-NL GND GND

1 SWDIO 2 ~{RESET}3 SWCLK 4 GND

Id: 7/9 Title: BLE module

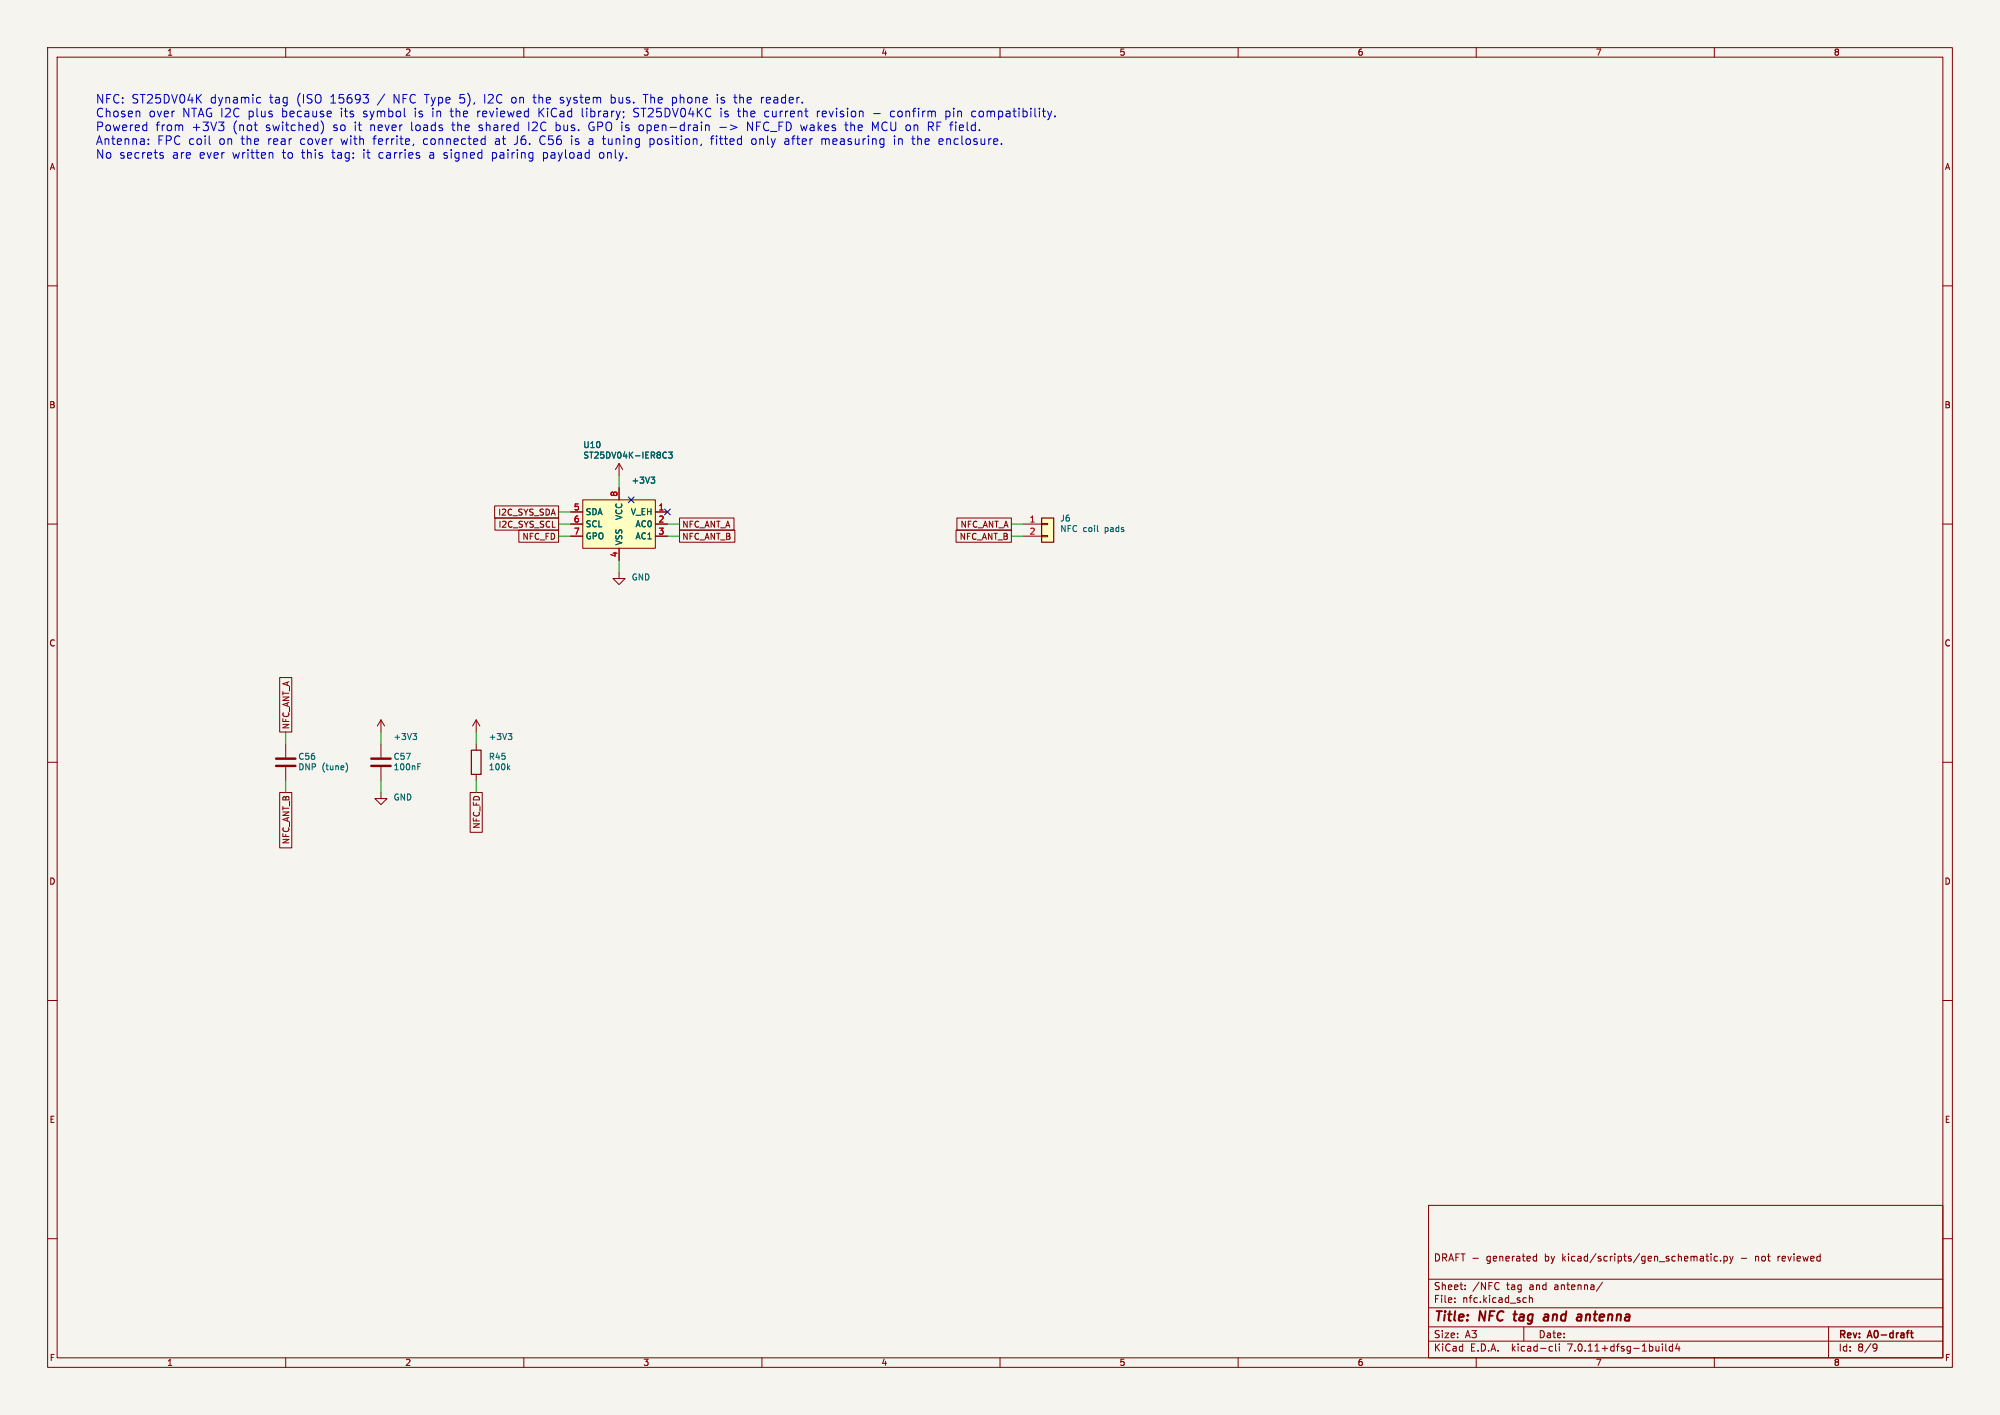
[picture p21: page 8]

4 SDA 5 SCL 6 GPO 7 VCC

Id: 8/9 Title: NFC tag and antenna

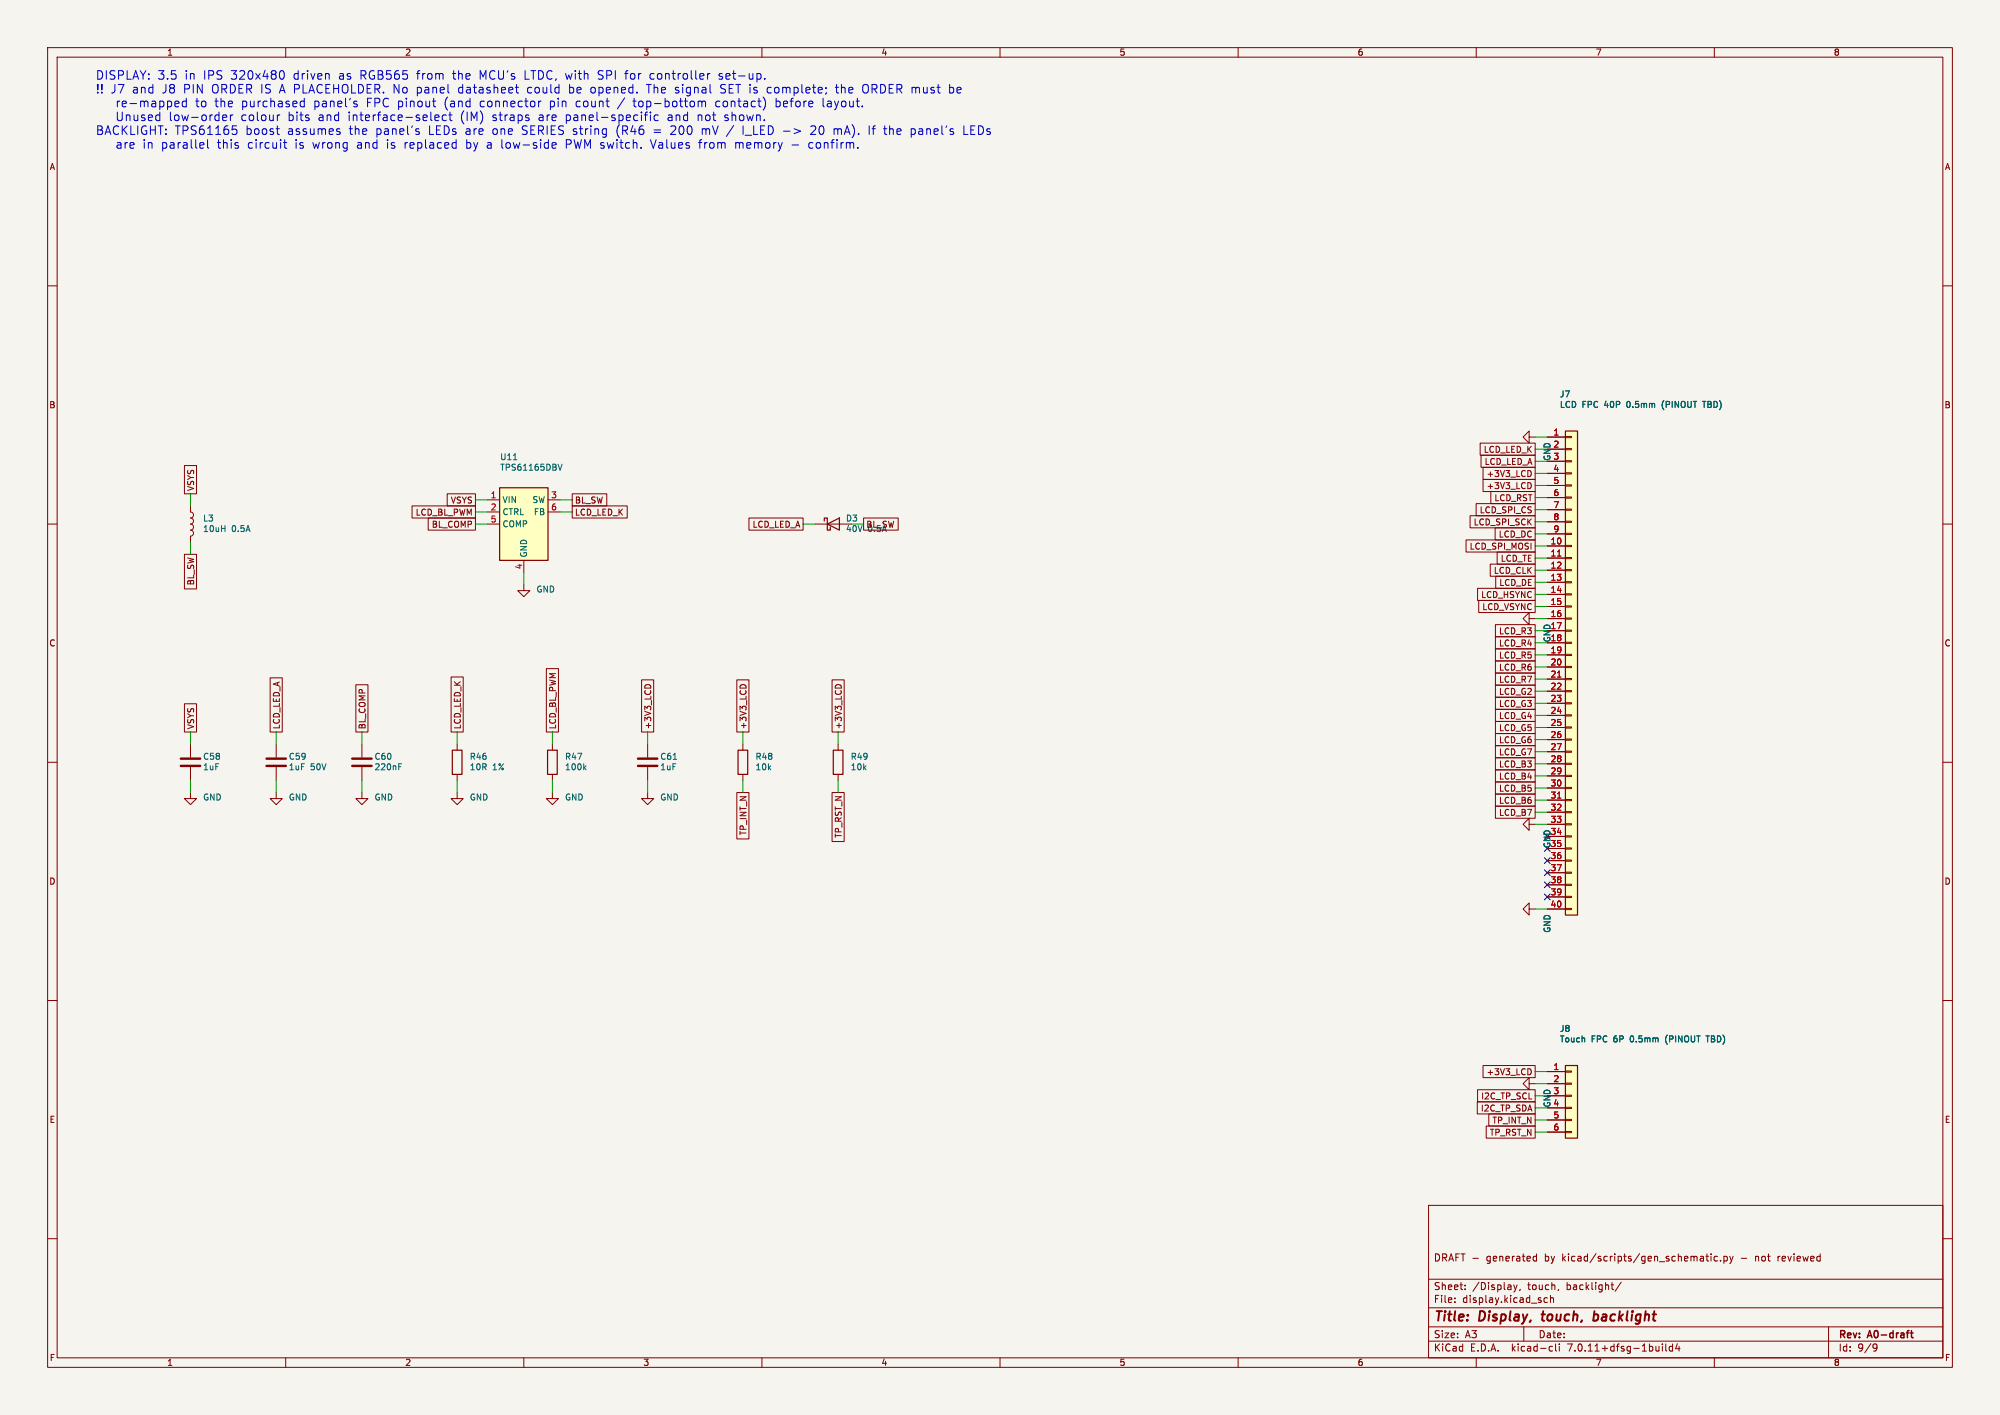
[picture p22: page 9]

LCD FPC 40P 0.5mm (PINOUT TBD) 1

LCD FPC 40P 0.5mm (PINOUT TBD) R48
