Oxjade/Circuit/kicad/ble.kicad_sch

## KiCad design kicad/ble.kicad_sch (2026-11-11)

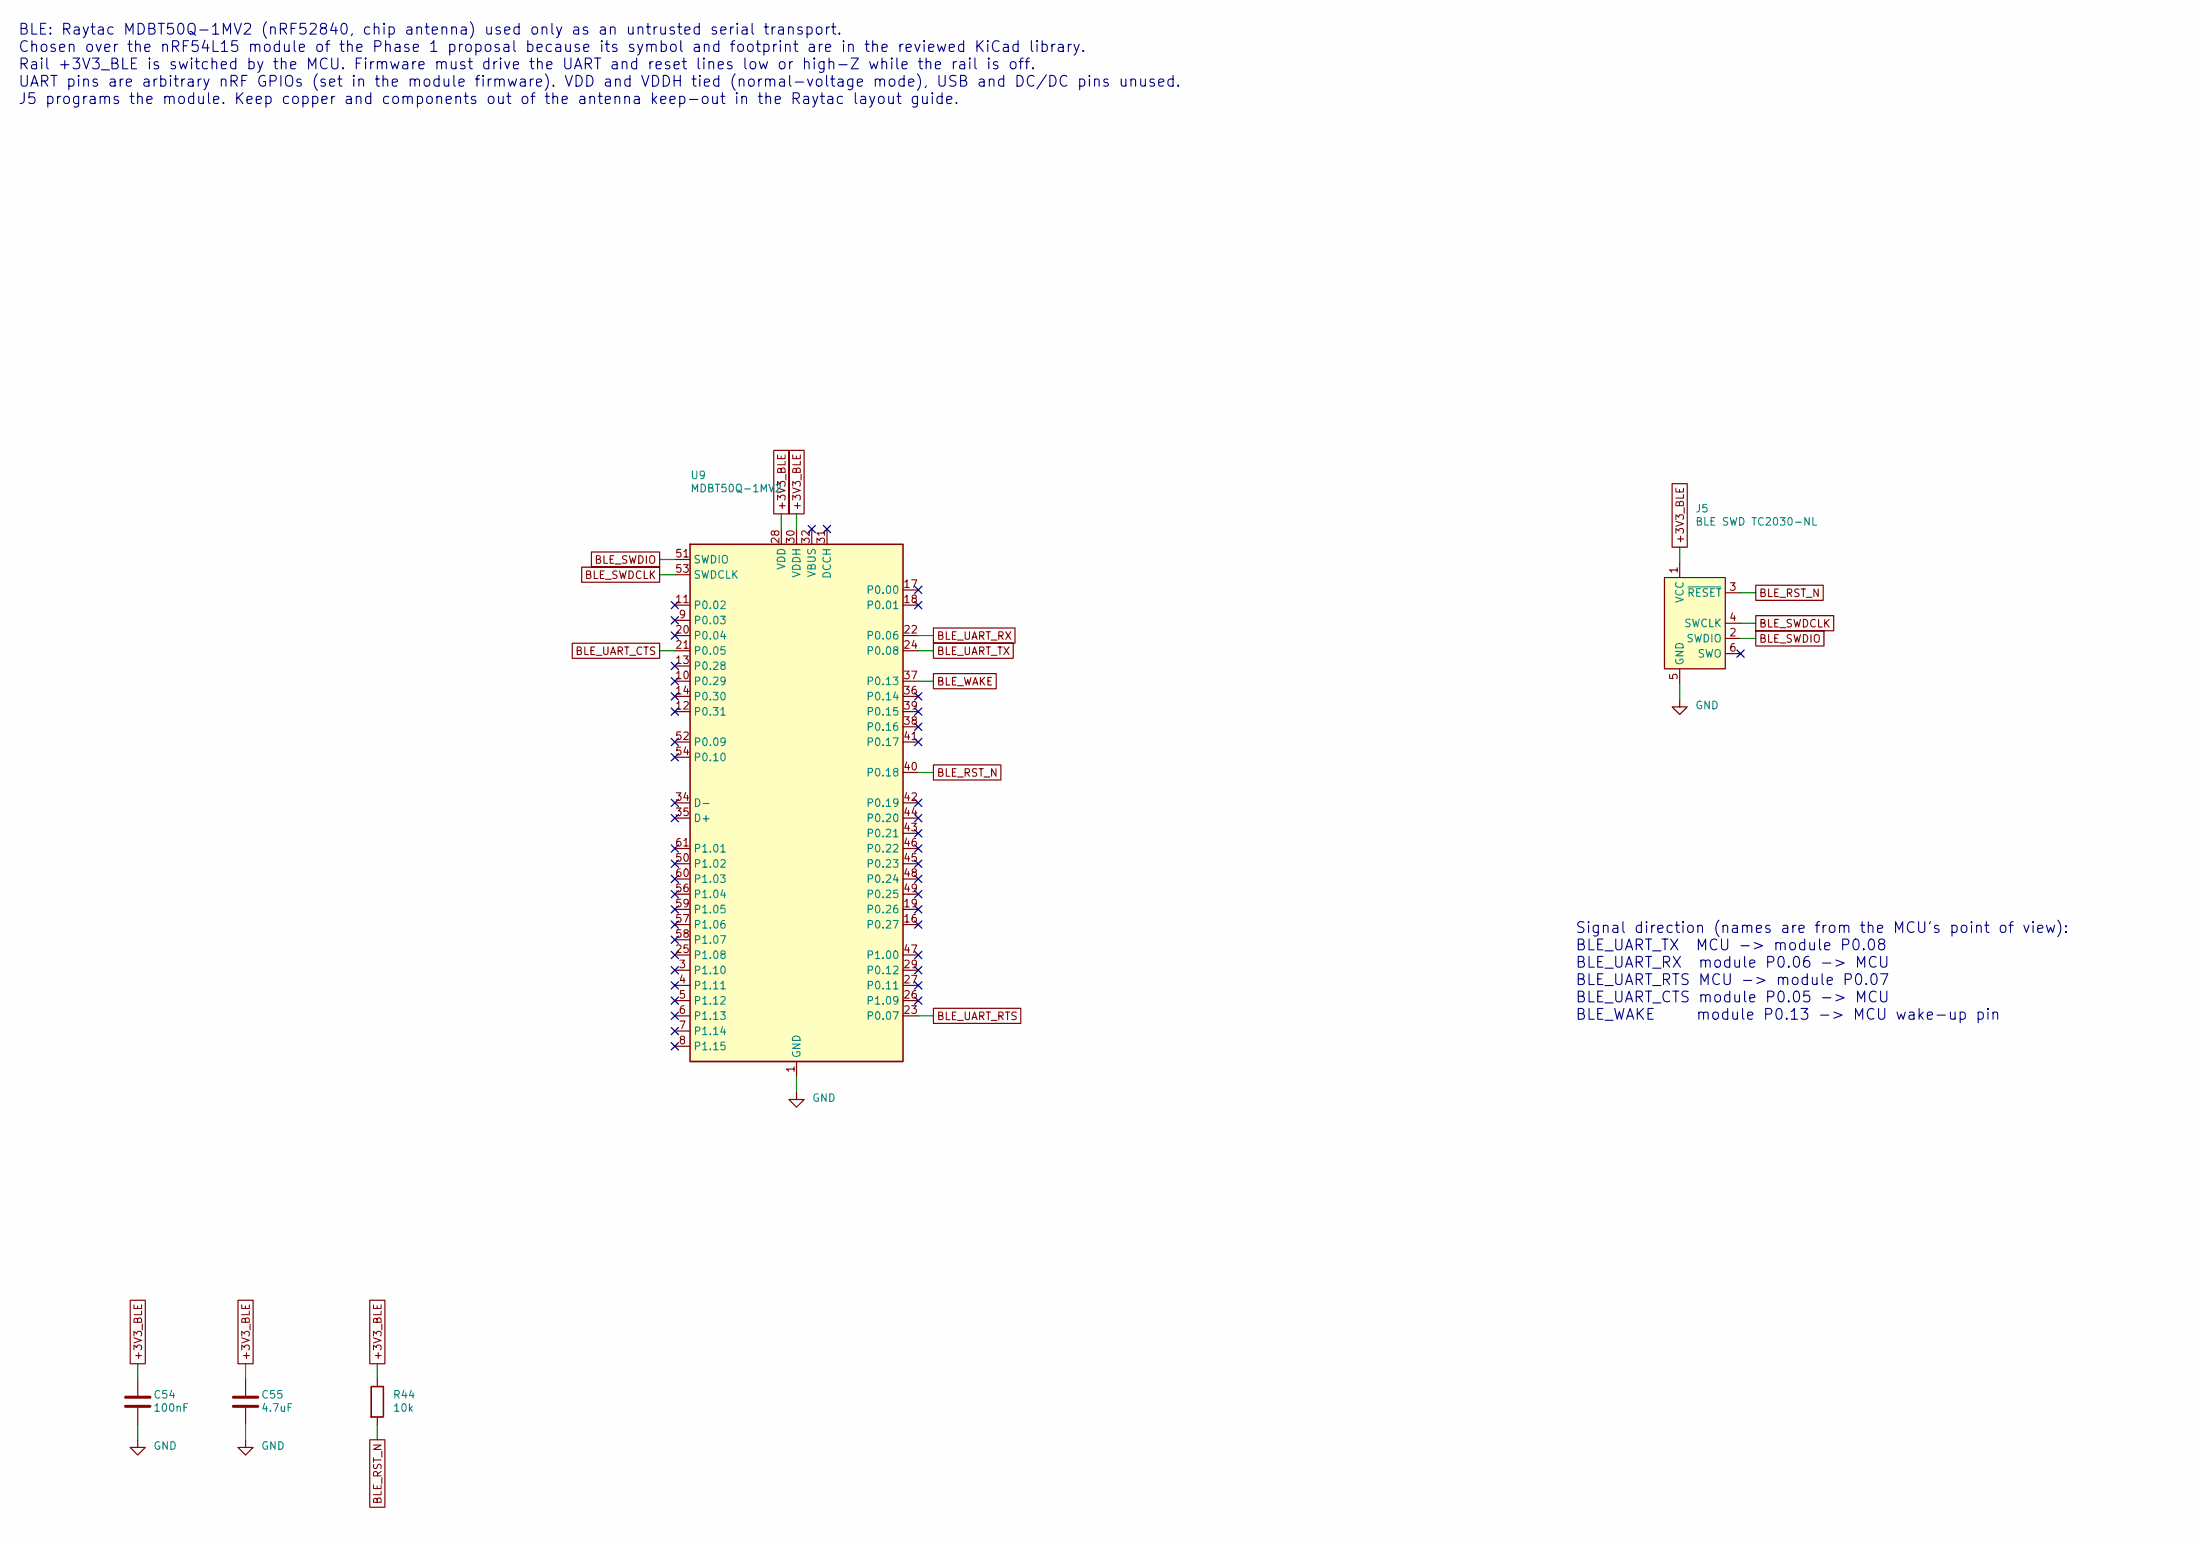
[picture p23: schematic ble.kicad_sch]

Parts:
C54: 100nF; C_0402_1005Metric
C55: 4.7uF; C_0603_1608Metric
J5: BLE SWD TC2030-NL; Tag-Connect_TC2030-IDC-NL_2x03_P1.27mm_Vertical
R44: 10k; R_0402_1005Metric
U9: MDBT50Q-1MV2; Raytac_MDBT50Q

Connections:
+3V3_BLE: C54.1, C55.1, J5.1 (VCC), R44.1, U9.28 (VDD), U9.30 (VDDH)
BLE_RST_N: J5.3 (~RESET), R44.2, U9.40 (P0.18)
BLE_SWDCLK: J5.4 (SWCLK), U9.53 (SWDCLK)
BLE_SWDIO: J5.2 (SWDIO), U9.51 (SWDIO)
BLE_UART_CTS: U9.21 (P0.05)
BLE_UART_RTS: U9.23 (P0.07)
BLE_UART_RX: U9.22 (P0.06)
BLE_UART_TX: U9.24 (P0.08)
BLE_WAKE: U9.37 (P0.13)
GND: C54.2, C55.2, J5.5 (GND), U9.1 (GND), U9.2 (GND), U9.15 (GND), U9.33 (GND), U9.55 (GND)

Notes on the sheet:
BLE: Raytac MDBT50Q-1MV2 (nRF52840, chip antenna) used only as an untrusted serial transport. Chosen over the nRF54L15 module of the Phase 1 proposal because its symbol and footprint are in the reviewed KiCad library. Rail +3V3_BLE is switched by the MCU. Firmware must drive the UART and reset line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
Signal direction (names are from the MCU's point of view): BLE_UART_TX MCU -> module P0.08 BLE_UART_RX module P0.06 -> MCU BLE_UART_RTS MCU -> module P0.07 BLE_UART_CTS module P0.05 -> MCU BLE_WAKE module P0.13 -> MCU wake-up pin
