Oxjade/Circuit/kicad/display.kicad_sch

## KiCad design kicad/display.kicad_sch (2026-11-11)

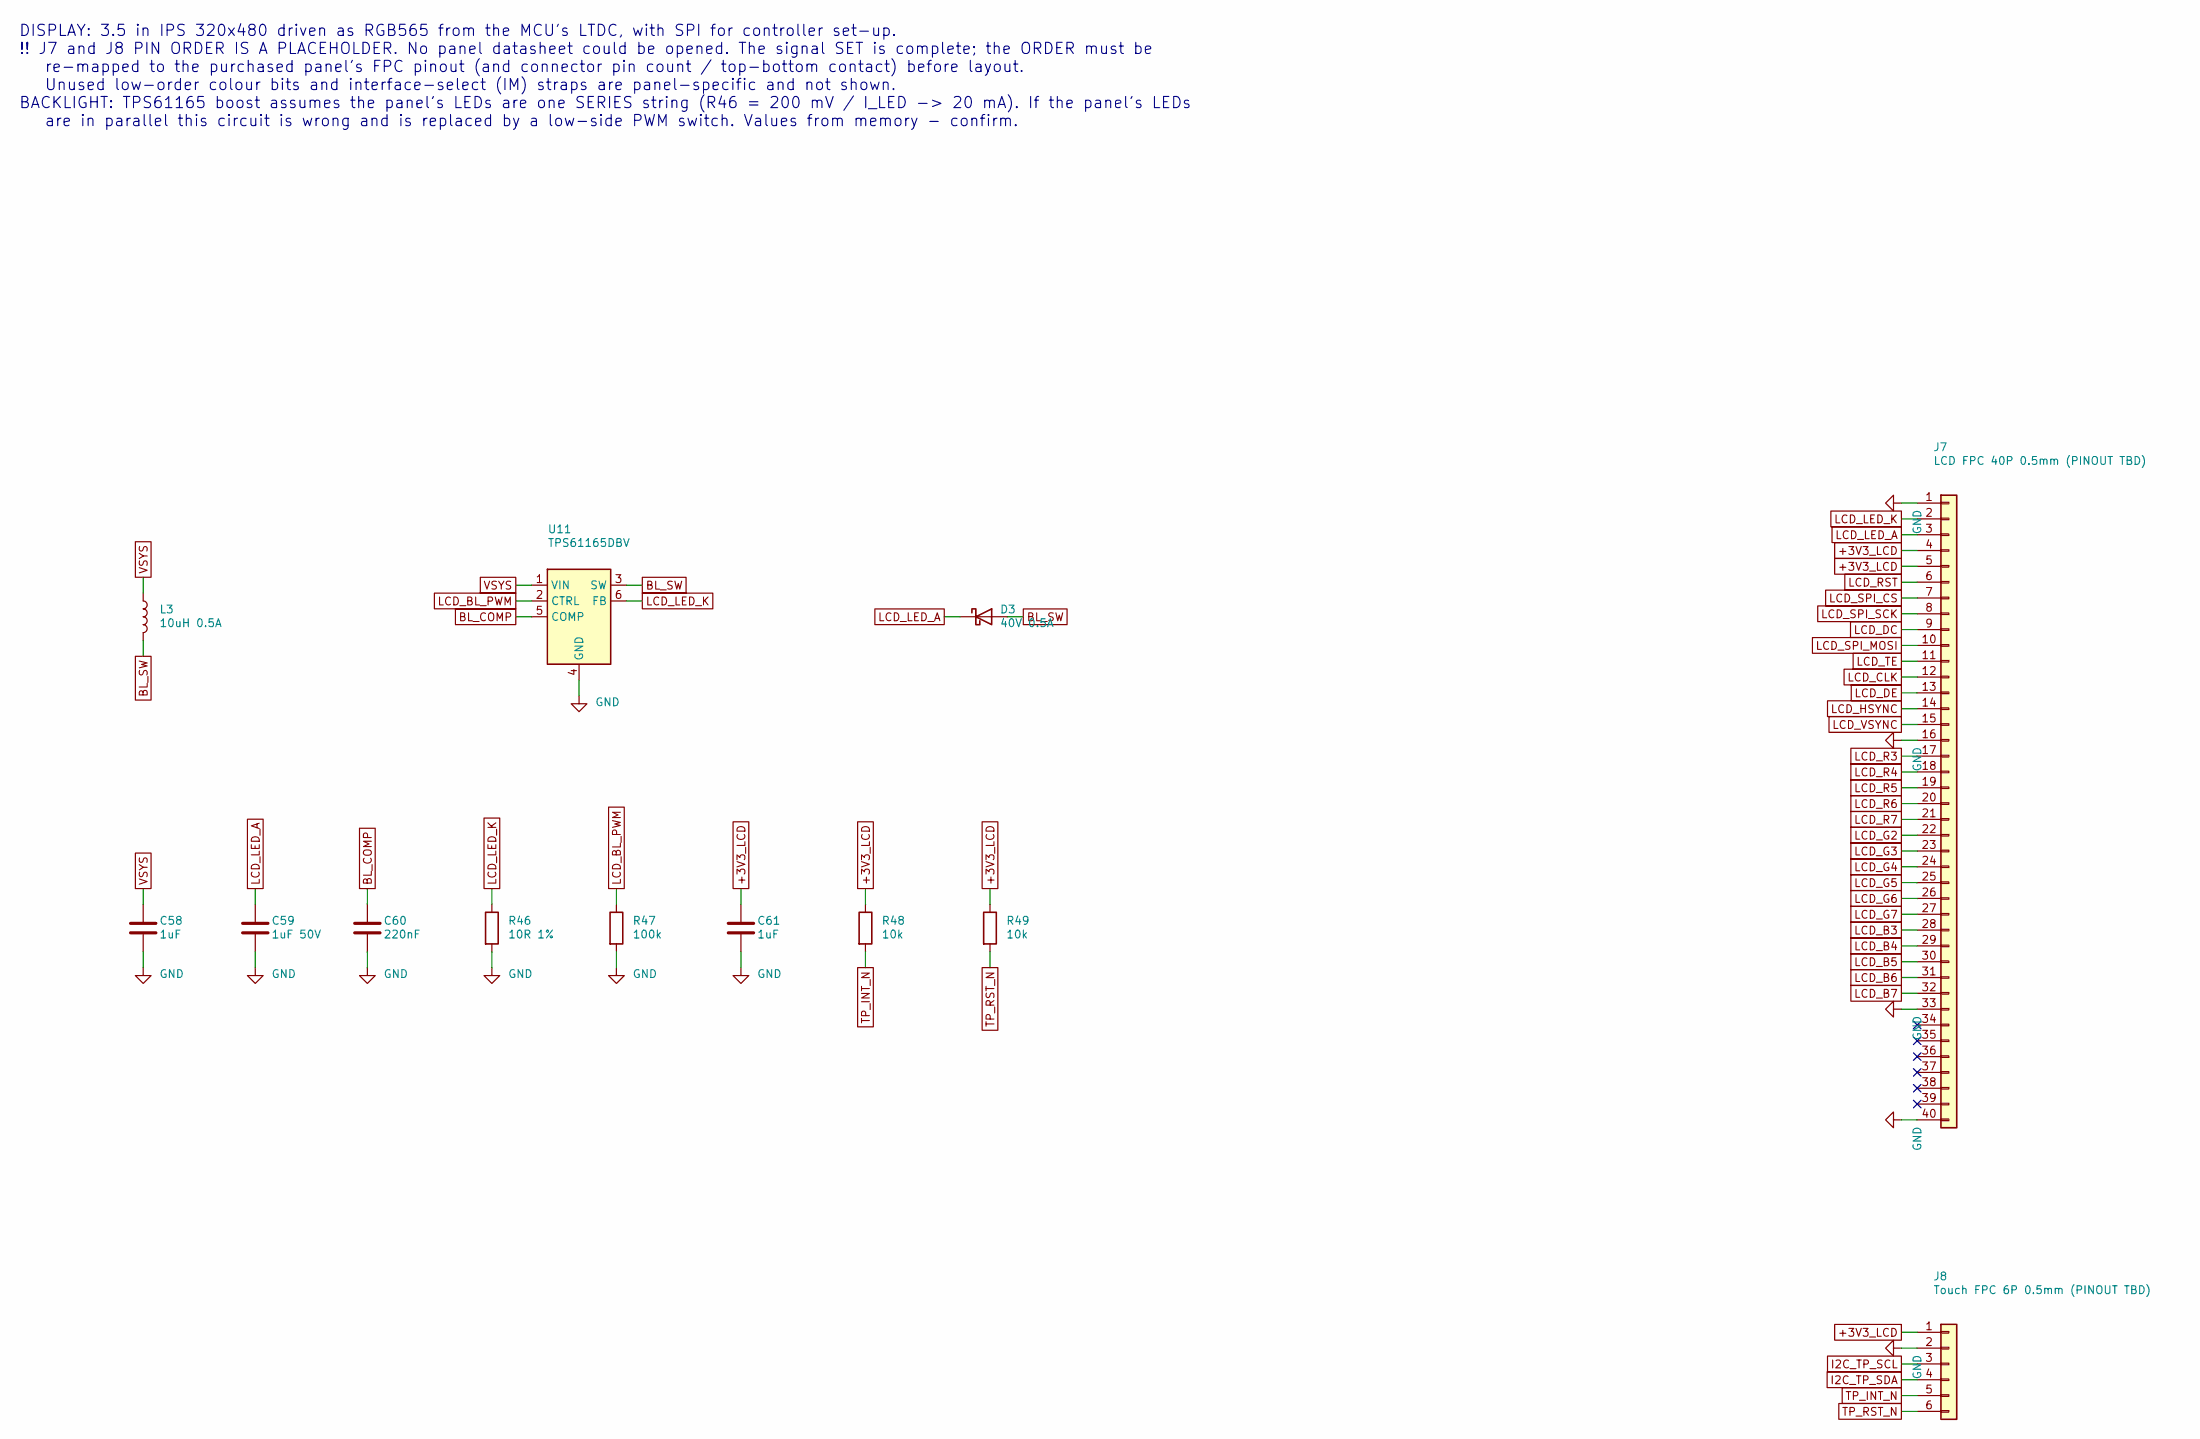
[picture p24: schematic display.kicad_sch]

Parts:
C58, C61: 1uF; C_0402_1005Metric
C59: 1uF 50V; C_0603_1608Metric
C60: 220nF; C_0402_1005Metric
D3: 40V 0.5A; D_SOD-123
J7: LCD FPC 40P 0.5mm (PINOUT TBD); Hirose_FH12-40S-0.5SH_1x40-1MP_P0.50mm_Horizontal
J8: Touch FPC 6P 0.5mm (PINOUT TBD); Hirose_FH12-6S-0.5SH_1x06-1MP_P0.50mm_Horizontal
L3: 10uH 0.5A; L_1008_2520Metric
R46: 10R 1%; R_0402_1005Metric
R47: 100k; R_0402_1005Metric
R48, R49: 10k; R_0402_1005Metric
U11: TPS61165DBV; SOT-23-6

Connections:
+3V3_LCD: C61.1, J7.4, J7.5, J8.1, R48.1, R49.1
BL_COMP: C60.1, U11.5 (COMP)
BL_SW: D3.2 (A), L3.2, U11.3 (SW)
GND: C58.2, C59.2, C60.2, C61.2, J7.1, J7.16, J7.33, J7.40, J8.2, R46.2, R47.2, U11.4 (GND)
I2C_TP_SCL: J8.3
I2C_TP_SDA: J8.4
LCD_B3: J7.28
LCD_B4: J7.29
LCD_B5: J7.30
LCD_B6: J7.31
LCD_B7: J7.32
LCD_BL_PWM: R47.1, U11.2 (CTRL)
LCD_CLK: J7.12
LCD_DC: J7.9
LCD_DE: J7.13
LCD_G2: J7.22
LCD_G3: J7.23
LCD_G4: J7.24
LCD_G5: J7.25
LCD_G6: J7.26
LCD_G7: J7.27
LCD_HSYNC: J7.14
LCD_LED_A: C59.1, D3.1 (K), J7.3
LCD_LED_K: J7.2, R46.1, U11.6 (FB)
LCD_R3: J7.17
LCD_R4: J7.18
LCD_R5: J7.19
LCD_R6: J7.20
LCD_R7: J7.21
LCD_RST: J7.6
LCD_SPI_CS: J7.7
LCD_SPI_MOSI: J7.10
LCD_SPI_SCK: J7.8
LCD_TE: J7.11
LCD_VSYNC: J7.15
TP_INT_N: J8.5, R48.2
TP_RST_N: J8.6, R49.2
VSYS: C58.1, L3.1, U11.1 (VIN)

Notes on the sheet:
DISPLAY: 3.5 in IPS 320x480 driven as RGB565 from the MCU's LTDC, with SPI for controller set-up. !! J7 and J8 PIN ORDER IS A PLACEHOLDER. No panel datasheet could be opened. The signal SET is complete; the ORDER must be re-mapped to the purchased panel's FPC pinout (and connector pin count / top-b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
