Oxjade/Circuit/kicad/hmi.kicad_sch

## KiCad design kicad/hmi.kicad_sch (2026-11-11)

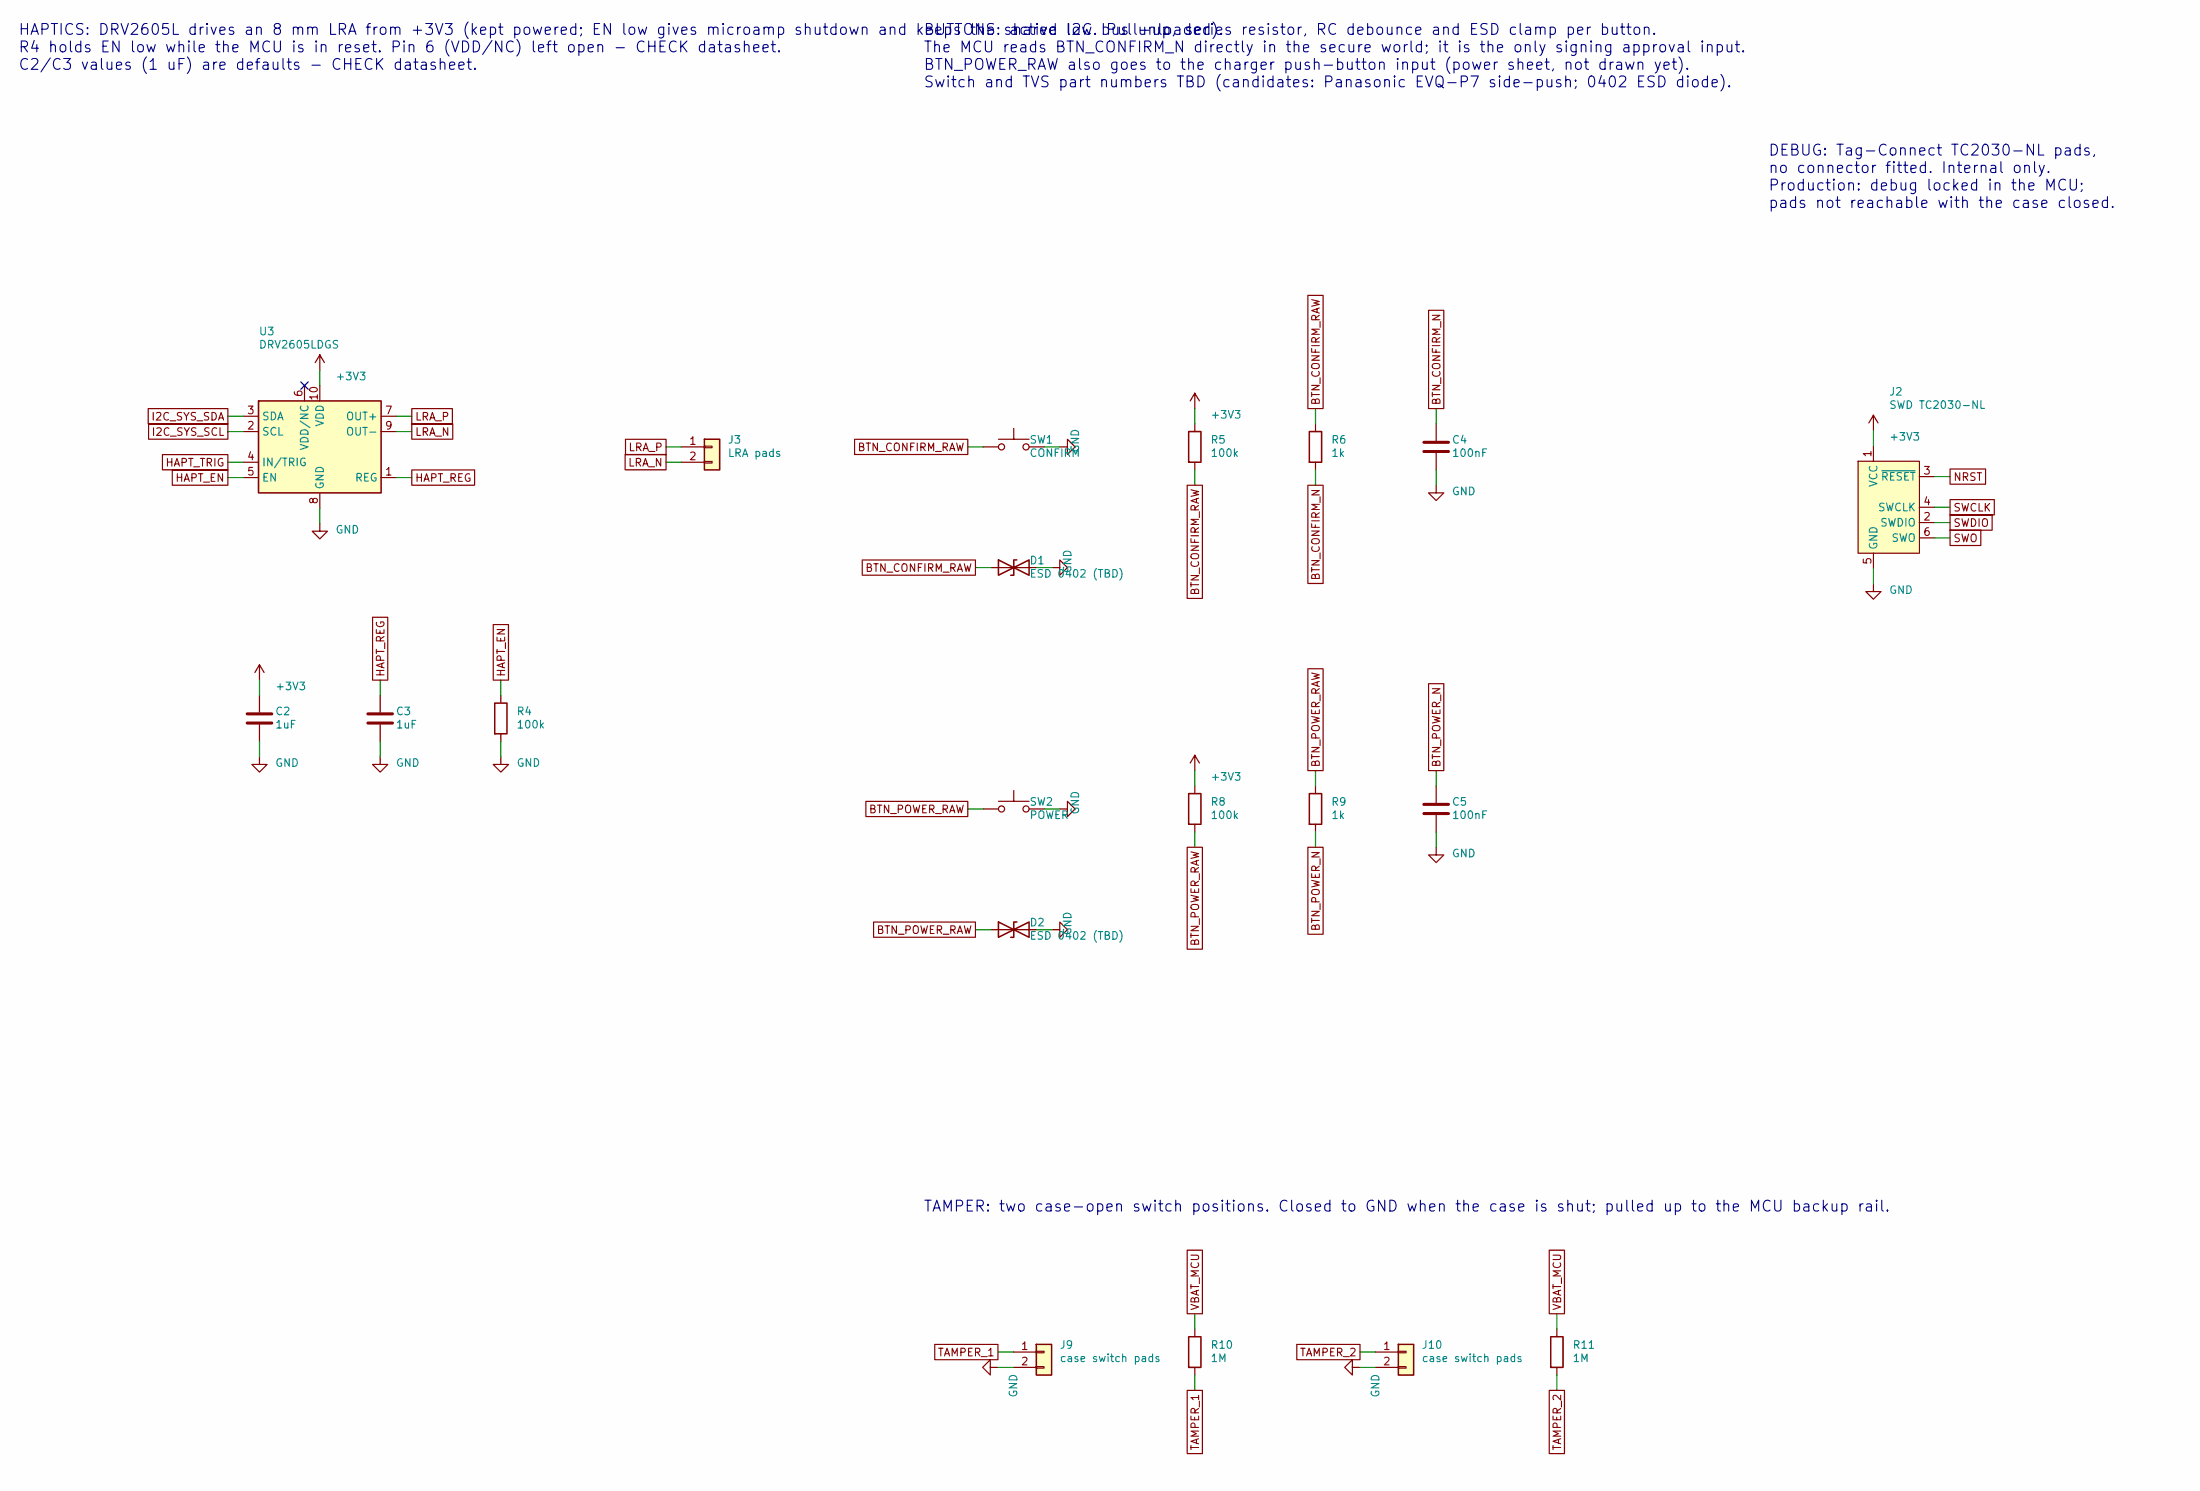
[picture p25: schematic hmi.kicad_sch]

Parts:
C2, C3: 1uF; C_0402_1005Metric
C4, C5: 100nF; C_0402_1005Metric
D1, D2: ESD 0402 (TBD)
J2: SWD TC2030-NL; Tag-Connect_TC2030-IDC-NL_2x03_P1.27mm_Vertical
J3: LRA pads
J9, J10: case switch pads
R4, R5, R8: 100k; R_0402_1005Metric
R6, R9: 1k; R_0402_1005Metric
R10, R11: 1M; R_0402_1005Metric
SW1: CONFIRM
SW2: POWER
U3: DRV2605LDGS; VSSOP-10_3x3mm_P0.5mm

Connections:
+3V3: C2.1, J2.1 (VCC), R5.1, R8.1, U3.10 (VDD)
BTN_CONFIRM_N: C4.1, R6.2
BTN_CONFIRM_RAW: D1.1 (A1), R5.2, R6.1, SW1.1
BTN_POWER_N: C5.1, R9.2
BTN_POWER_RAW: D2.1 (A1), R8.2, R9.1, SW2.1
GND: C2.2, C3.2, C4.2, C5.2, D1.2 (A2), D2.2 (A2), J2.5 (GND), J9.2, J10.2, R4.2, SW1.2, SW2.2, U3.8 (GND)
HAPT_EN: R4.1, U3.5 (EN)
HAPT_REG: C3.1, U3.1 (REG)
HAPT_TRIG: U3.4 (IN/TRIG)
I2C_SYS_SCL: U3.2 (SCL)
I2C_SYS_SDA: U3.3 (SDA)
LRA_N: J3.2, U3.9 (OUT-)
LRA_P: J3.1, U3.7 (OUT+)
NRST: J2.3 (~RESET)
SWCLK: J2.4 (SWCLK)
SWDIO: J2.2 (SWDIO)
SWO: J2.6 (SWO)
TAMPER_1: J9.1, R10.2
TAMPER_2: J10.1, R11.2
VBAT_MCU: R10.1, R11.1

Notes on the sheet:
HAPTICS: DRV2605L drives an 8 mm LRA from +3V3 (kept powered; EN low gives microamp shutdown and keeps the shared I2C bus unloaded). R4 holds EN low while the MCU is in reset. Pin 6 (VDD/NC) left open - CHECK datasheet. C2/C3 values (1 uF) are defaults - CHECK datasheet.
BUTTONS: active low. Pull-up, series resistor, RC debounce and ESD clamp per button. The MCU reads BTN_CONFIRM_N directly in the secure world; it is the only signing approval input. BTN_POWER_RAW also goes to the charger push-button input (power sheet, not drawn yet). Switch and TVS part numbers TB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
TAMPER: two case-open switch positions. Closed to GND when the case is shut; pulled up to the MCU backup rail.
DEBUG: Tag-Connect TC2030-NL pads, no connector fitted. Internal only. Production: debug locked in the MCU; pads not reachable with the case closed.
