Oxjade/Circuit/kicad/mcu.kicad_sch

## KiCad design kicad/mcu.kicad_sch (2026-11-11)

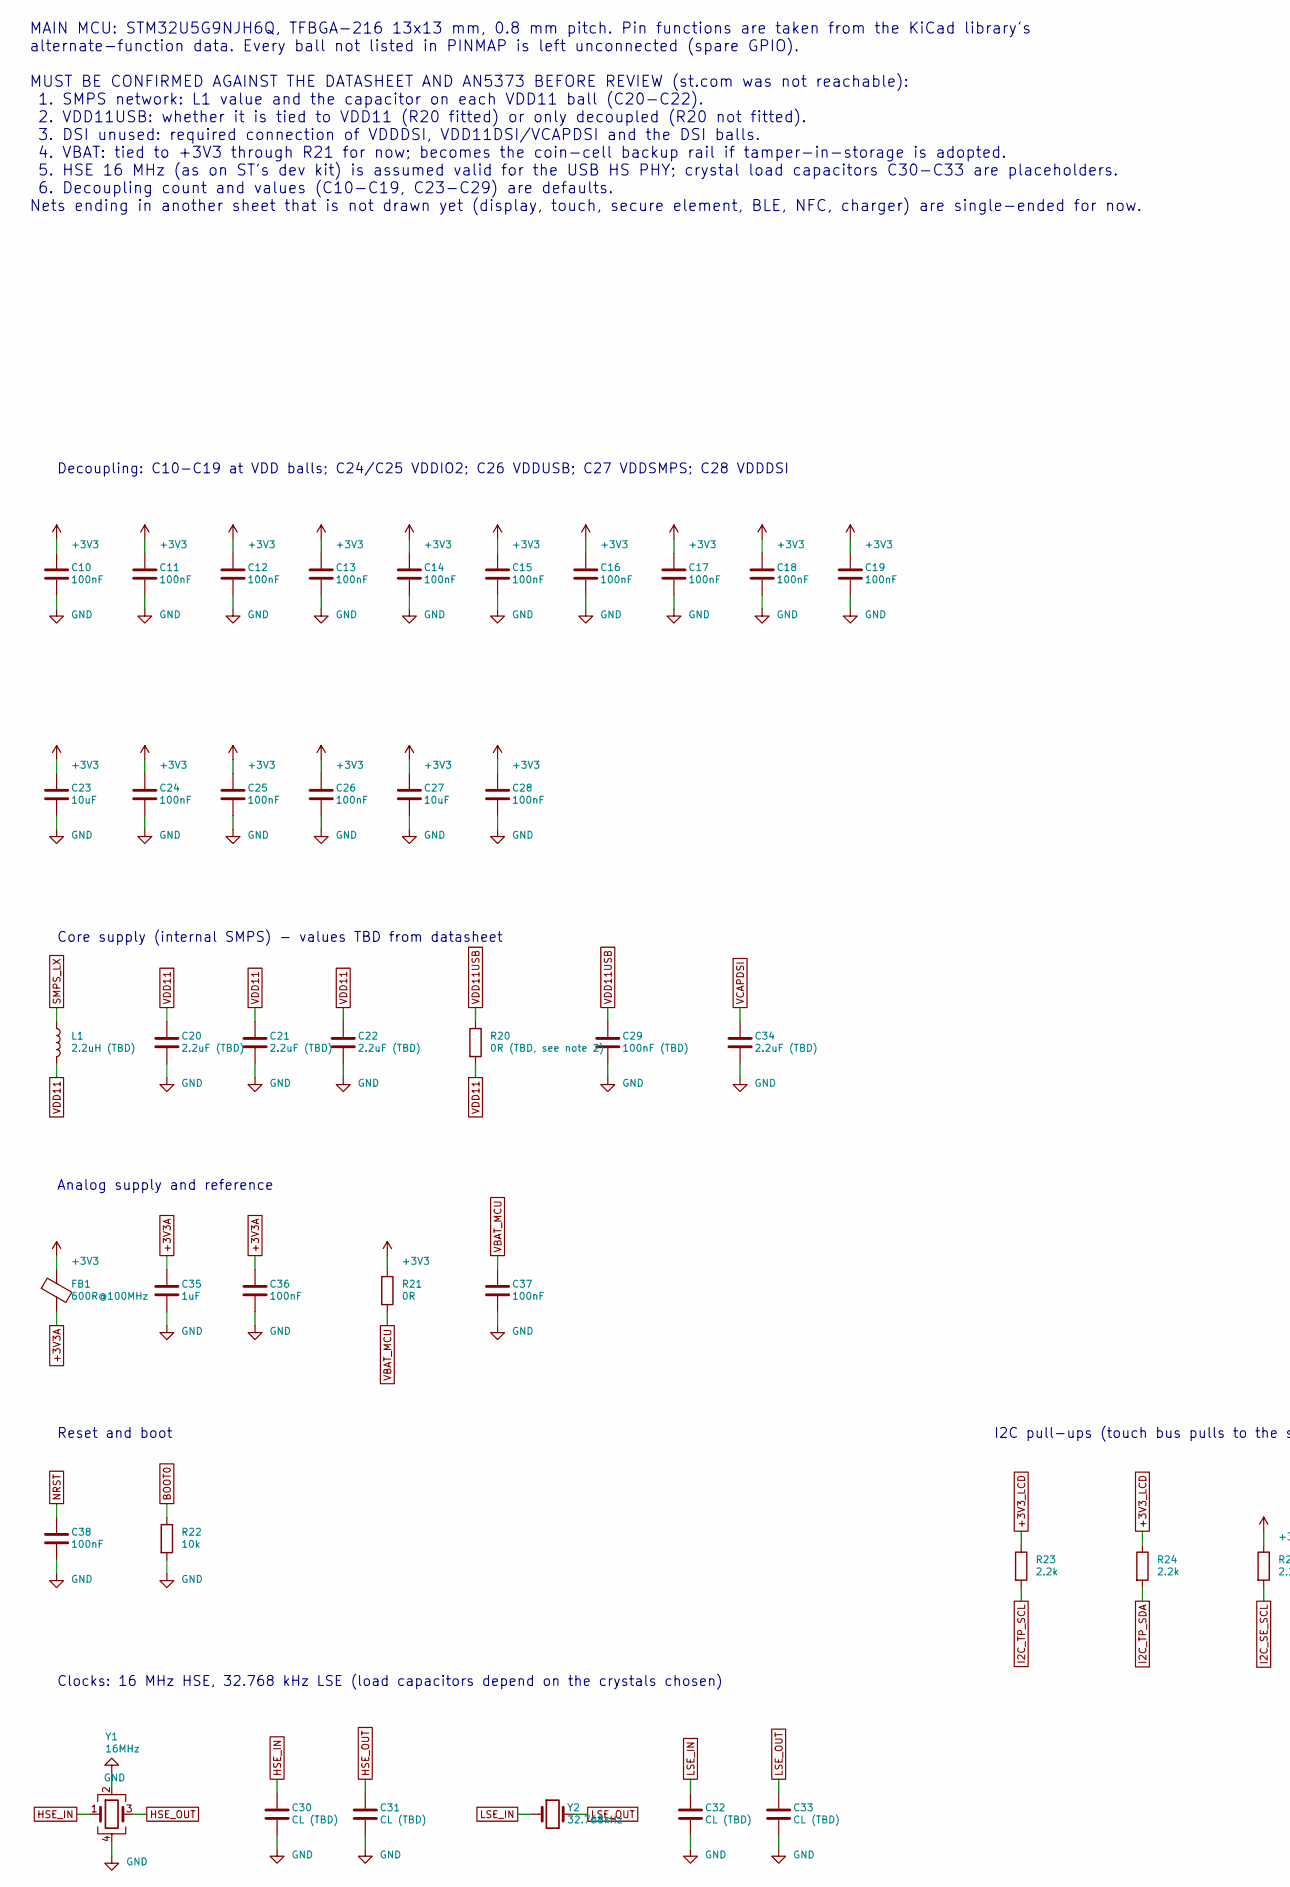
[picture p26: schematic mcu.kicad_sch, part in row 1, column 1]

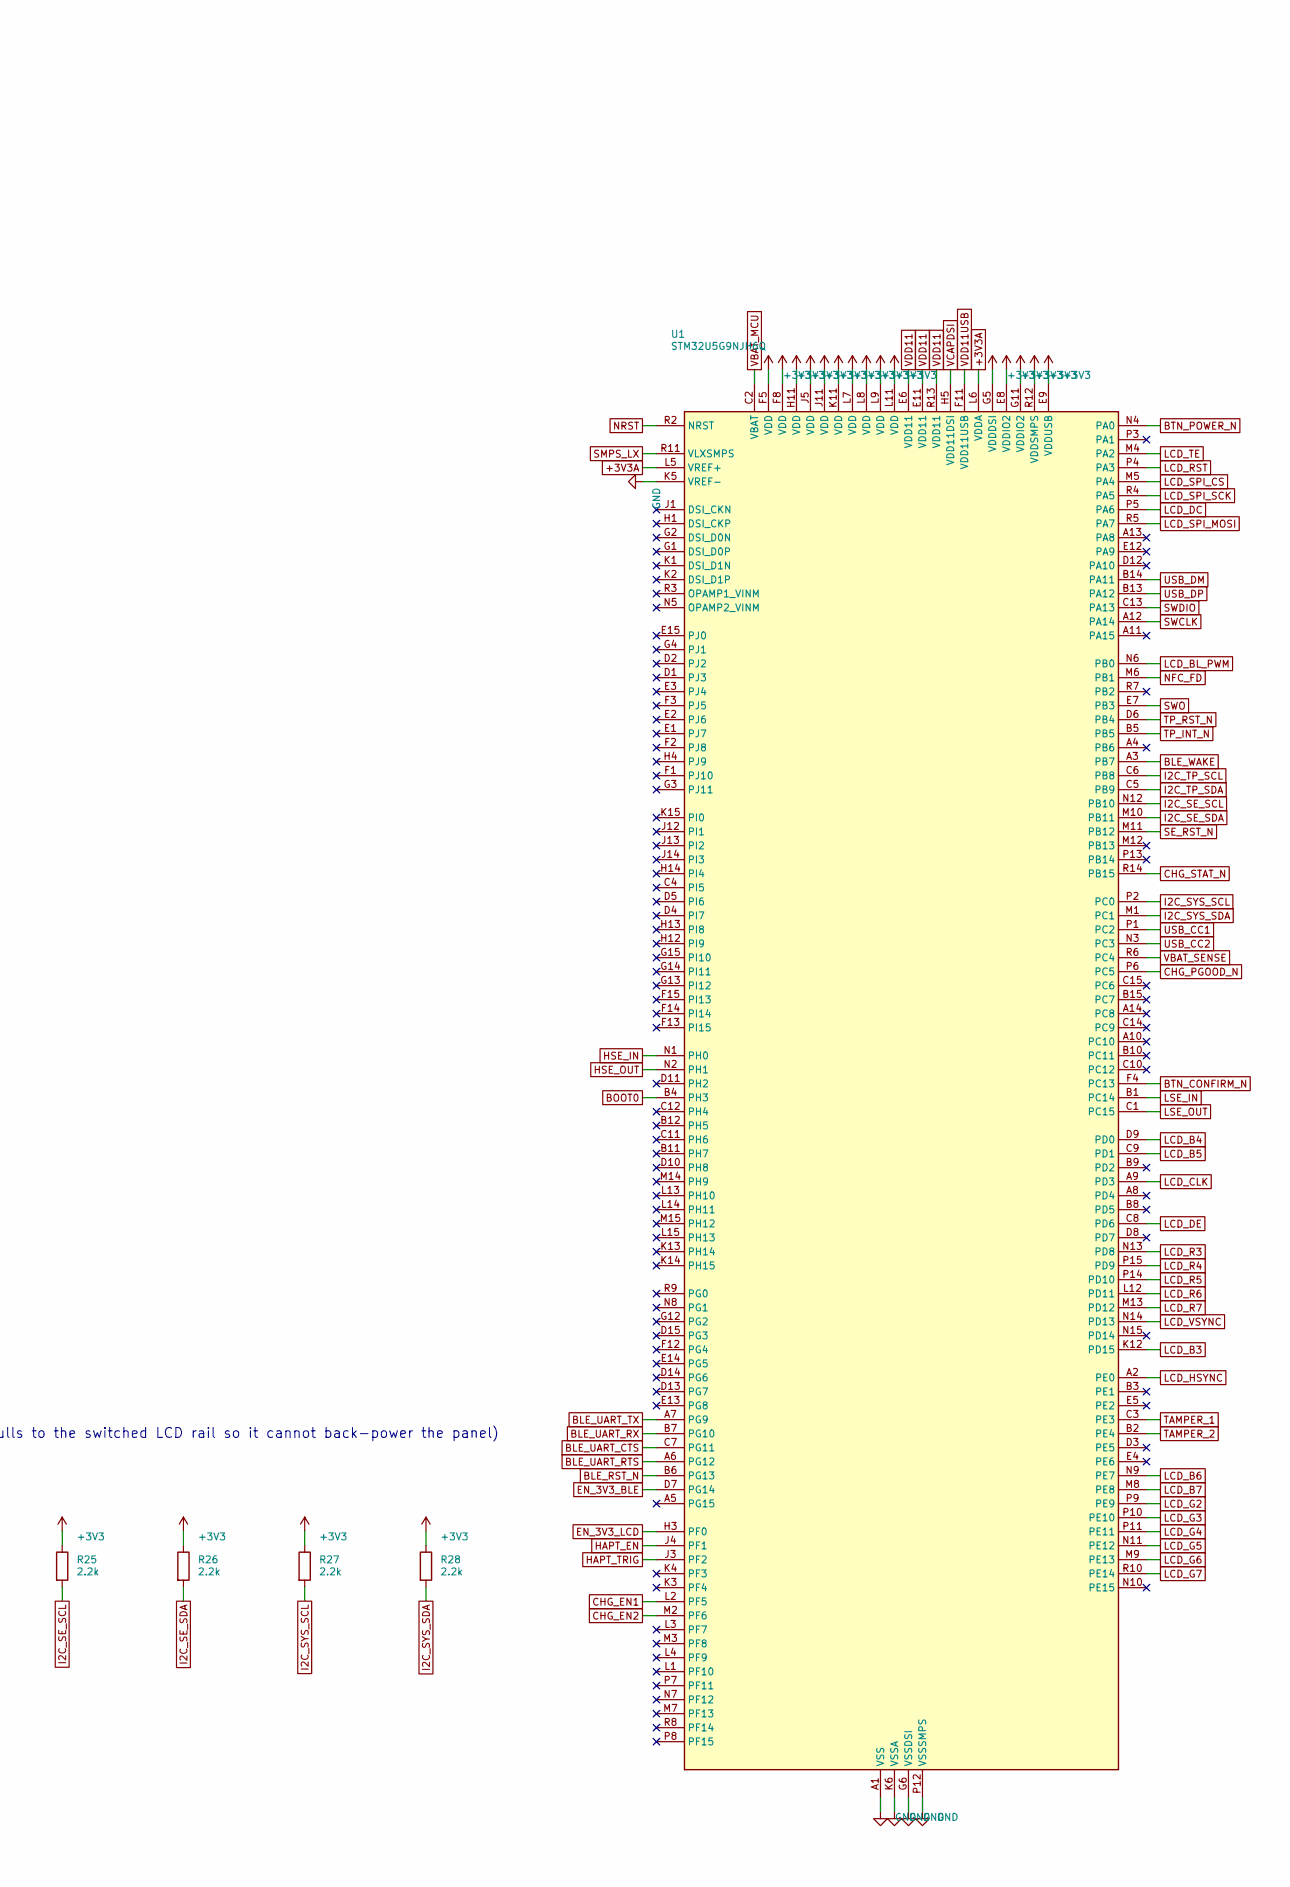
[picture p27: schematic mcu.kicad_sch, part in row 1, column 2]

Parts:
C10, C11, C12, C13, C14, C15, C16, C17, C18, C19, C24, C25, C26, C28, C36, C37, C38: 100nF; C_0402_1005Metric
C20, C21, C22, C34: 2.2uF (TBD); C_0402_1005Metric
C23, C27: 10uF; C_0603_1608Metric
C29: 100nF (TBD); C_0402_1005Metric
C30, C31, C32, C33: CL (TBD); C_0402_1005Metric
C35: 1uF; C_0402_1005Metric
FB1: 600R@100MHz; L_0402_1005Metric
L1: 2.2uH (TBD); L_0805_2012Metric
R20: 0R (TBD, see note 2); R_0402_1005Metric
R21: 0R; R_0402_1005Metric
R22: 10k; R_0402_1005Metric
R23, R24, R25, R26, R27, R28: 2.2k; R_0402_1005Metric
U1: STM32U5G9NJH6Q; TFBGA-216_13x13mm_Layout15x15_P0.8mm
Y1: 16MHz; Crystal_SMD_2016-4Pin_2.0x1.6mm
Y2: 32.768kHz; Crystal_SMD_3215-2Pin_3.2x1.5mm

Connections:
+3V3: C10.1, C11.1, C12.1, C13.1, C14.1, C15.1, C16.1, C17.1, C18.1, C19.1, C23.1, C24.1, C25.1, C26.1, C27.1, C28.1, FB1.1, R21.1, R25.1, R26.1, R27.1, R28.1, U1.E8 (VDDIO2), U1.E9 (VDDUSB), U1.F5 (VDD), U1.F8 (VDD), U1.G5 (VDDDSI), U1.G11 (VDDIO2), U1.H11 (VDD), U1.J5 (VDD), U1.J11 (VDD), U1.K11 (VDD), U1.L7 (VDD), U1.L8 (VDD), U1.L9 (VDD), U1.L11 (VDD), U1.R12 (VDDSMPS)
+3V3A: C35.1, C36.1, FB1.2, U1.L5 (VREF+), U1.L6 (VDDA)
+3V3_LCD: R23.1, R24.1
BLE_RST_N: U1.B6 (PG13)
BLE_UART_CTS: U1.C7 (PG11)
BLE_UART_RTS: U1.A6 (PG12)
BLE_UART_RX: U1.B7 (PG10)
BLE_UART_TX: U1.A7 (PG9)
BLE_WAKE: U1.A3 (PB7)
BOOT0: R22.1, U1.B4 (PH3)
BTN_CONFIRM_N: U1.F4 (PC13)
BTN_POWER_N: U1.N4 (PA0)
CHG_EN1: U1.L2 (PF5)
CHG_EN2: U1.M2 (PF6)
CHG_PGOOD_N: U1.P6 (PC5)
CHG_STAT_N: U1.R14 (PB15)
EN_3V3_BLE: U1.D7 (PG14)
EN_3V3_LCD: U1.H3 (PF0)
GND: C10.2, C11.2, C12.2, C13.2, C14.2, C15.2, C16.2, C17.2, C18.2, C19.2, C20.2, C21.2, C22.2, C23.2, C24.2, C25.2, C26.2, C27.2, C28.2, C29.2, C30.2, C31.2, C32.2, C33.2, C34.2, C35.2, C36.2, C37.2, C38.2, R22.2, U1.A1 (VSS), U1.A15 (VSS), U1.E10 (VSS), U1.F6 (VSS), U1.F7 (VSS), U1.F9 (VSS), U1.F10 (VSS), U1.G6 (VSSDSI), U1.G10 (VSS), U1.H2 (VSSDSI), U1.H6 (VSSDSI), U1.H10 (VSS), U1.H15 (VSS), U1.J2 (VSSDSI), U1.J6 (VSS), U1.J10 (VSS), U1.J15 (VSS), U1.K5 (VREF-), U1.K6 (VSSA), U1.K7 (VSS), U1.K8 (VSS), U1.K9 (VSS), U1.K10 (VSS), U1.L10 (VSS), U1.P12 (VSSSMPS), U1.R1 (VSS), U1.R15 (VSS), Y1.2, Y1.4
HAPT_EN: U1.J4 (PF1)
HAPT_TRIG: U1.J3 (PF2)
HSE_IN: C30.1, U1.N1 (PH0), Y1.1
HSE_OUT: C31.1, U1.N2 (PH1), Y1.3
I2C_SE_SCL: R25.2, U1.N12 (PB10)
I2C_SE_SDA: R26.2, U1.M10 (PB11)
I2C_SYS_SCL: R27.2, U1.P2 (PC0)
I2C_SYS_SDA: R28.2, U1.M1 (PC1)
I2C_TP_SCL: R23.2, U1.C6 (PB8)
I2C_TP_SDA: R24.2, U1.C5 (PB9)
LCD_B3: U1.K12 (PD15)
LCD_B4: U1.D9 (PD0)
LCD_B5: U1.C9 (PD1)
LCD_B6: U1.N9 (PE7)
LCD_B7: U1.M8 (PE8)
LCD_BL_PWM: U1.N6 (PB0)
LCD_CLK: U1.A9 (PD3)
LCD_DC: U1.P5 (PA6)
LCD_DE: U1.C8 (PD6)
LCD_G2: U1.P9 (PE9)
LCD_G3: U1.P10 (PE10)
LCD_G4: U1.P11 (PE11)
LCD_G5: U1.N11 (PE12)
LCD_G6: U1.M9 (PE13)
LCD_G7: U1.R10 (PE14)
LCD_HSYNC: U1.A2 (PE0)
LCD_R3: U1.N13 (PD8)
LCD_R4: U1.P15 (PD9)
LCD_R5: U1.P14 (PD10)
LCD_R6: U1.L12 (PD11)
LCD_R7: U1.M13 (PD12)
LCD_RST: U1.P4 (PA3)
LCD_SPI_CS: U1.M5 (PA4)
LCD_SPI_MOSI: U1.R5 (PA7)
LCD_SPI_SCK: U1.R4 (PA5)
LCD_TE: U1.M4 (PA2)
LCD_VSYNC: U1.N14 (PD13)
LSE_IN: C32.1, U1.B1 (PC14), Y2.1
LSE_OUT: C33.1, U1.C1 (PC15), Y2.2
NFC_FD: U1.M6 (PB1)
NRST: C38.1, U1.R2 (NRST)
SE_RST_N: U1.M11 (PB12)
SMPS_LX: L1.1, U1.R11 (VLXSMPS)
SWCLK: U1.A12 (PA14)
SWDIO: U1.C13 (PA13)
SWO: U1.E7 (PB3)
TAMPER_1: U1.C3 (PE3)
TAMPER_2: U1.B2 (PE4)
TP_INT_N: U1.B5
TP_RST_N: U1.D6 (PB4)
USB_CC1: U1.P1 (PC2)
USB_CC2: U1.N3 (PC3)
USB_DM: U1.B14 (PA11)
USB_DP: U1.B13 (PA12)
VBAT_MCU: C37.1, R21.2, U1.C2 (VBAT)
VBAT_SENSE: U1.R6 (PC4)
VCAPDSI: C34.1, U1.H5 (VDD11DSI)
VDD11: C20.1, C21.1, C22.1, L1.2, R20.2, U1.E6 (VDD11), U1.E11 (VDD11), U1.R13 (VDD11)
VDD11USB: C29.1, R20.1, U1.F11 (VDD11USB)

Notes on the sheet:
MAIN MCU: STM32U5G9NJH6Q, TFBGA-216 13x13 mm, 0.8 mm pitch. Pin functions are taken from the KiCad library's alternate-function data. Every ball not listed in PINMAP is left unconnected (spare GPIO). MUST BE CONFIRMED AGAINST THE DATASHEET AND AN5373 BEFORE REVIEW (st.com was not reachable): 1. SMP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
Decoupling: C10-C19 at VDD balls; C24/C25 VDDIO2; C26 VDDUSB; C27 VDDSMPS; C28 VDDDSI
Core supply (internal SMPS) - values TBD from datasheet
Analog supply and reference
Reset and boot
Clocks: 16 MHz HSE, 32.768 kHz LSE (load capacitors depend on the crystals chosen)
I2C pull-ups (touch bus pulls to the switched LCD rail so it cannot back-power the panel)
