Oxjade/Circuit/kicad/nfc.kicad_sch

## KiCad design kicad/nfc.kicad_sch (2026-11-11)

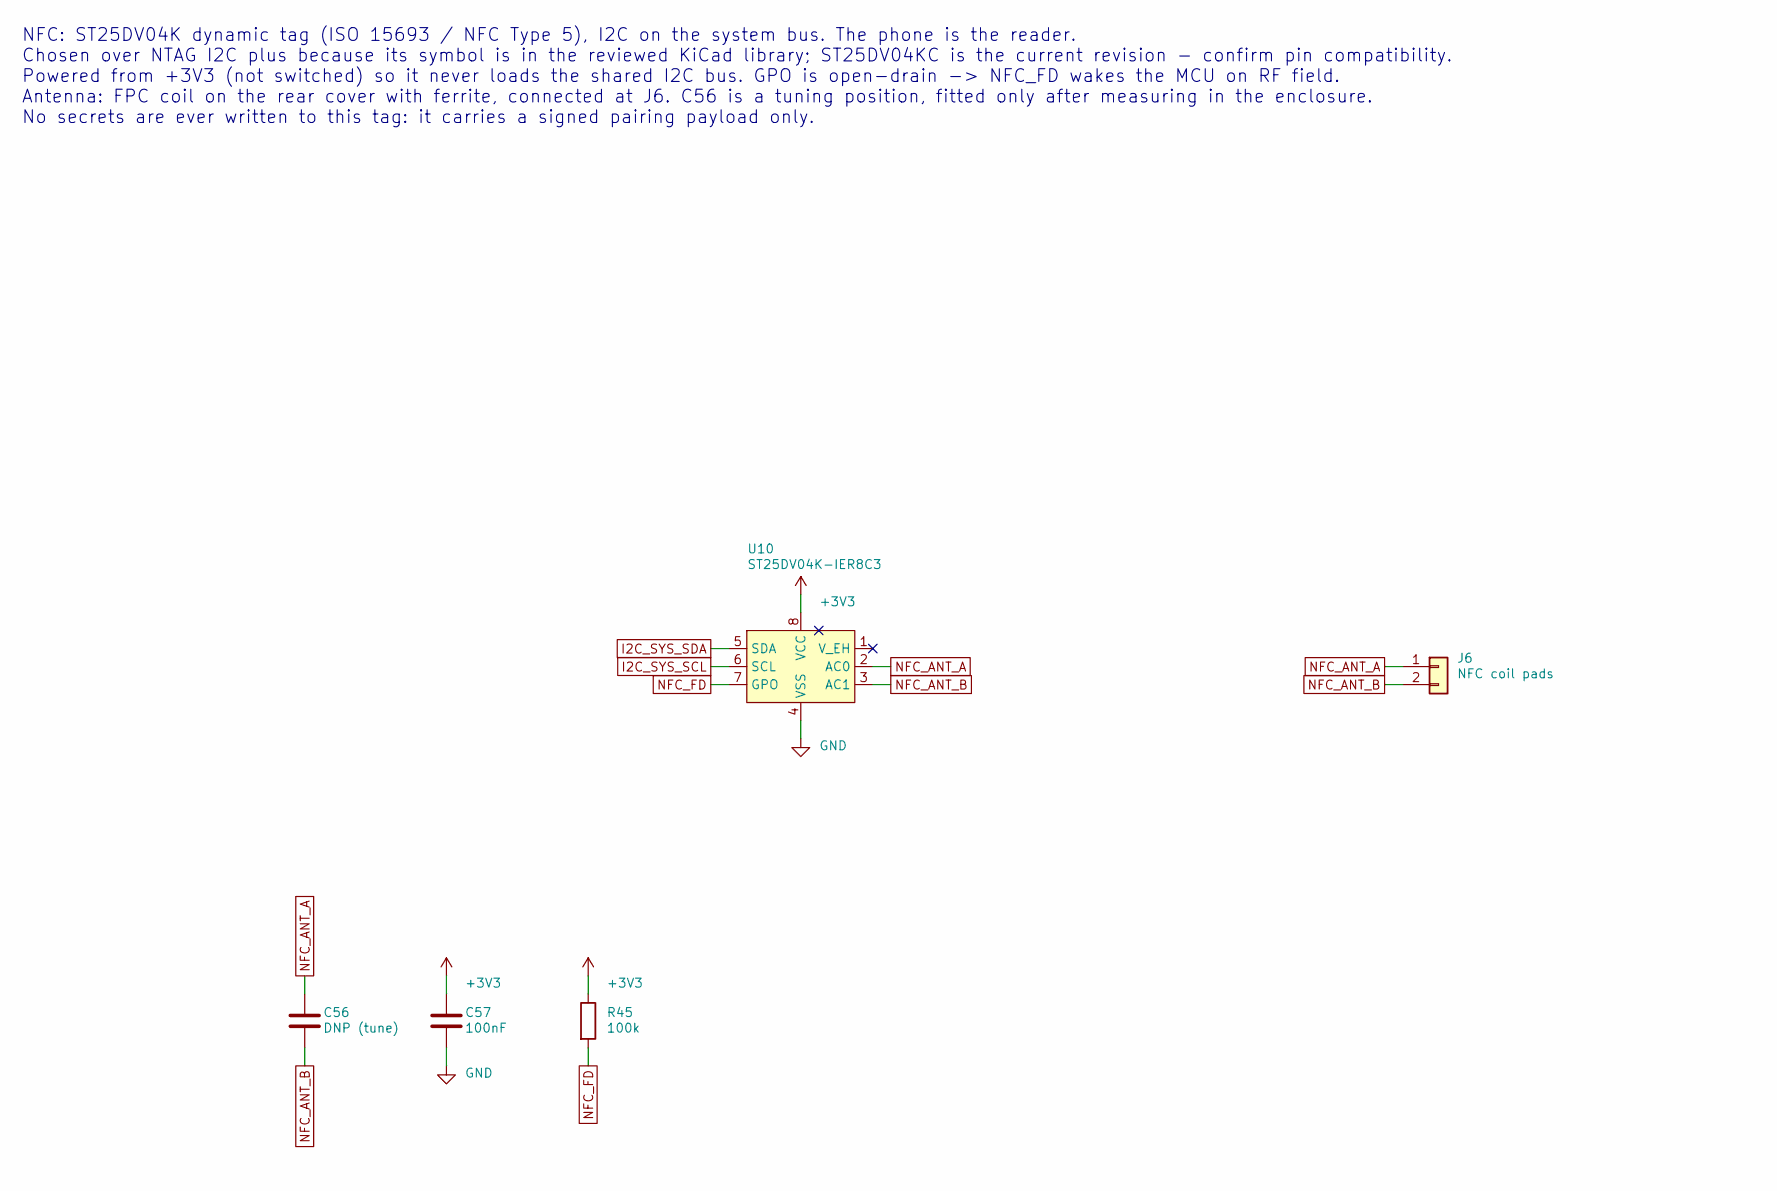
[picture p28: schematic nfc.kicad_sch]

Parts:
C56: DNP (tune); C_0402_1005Metric
C57: 100nF; C_0402_1005Metric
J6: NFC coil pads
R45: 100k; R_0402_1005Metric
U10: ST25DV04K-IER8C3; DFN-8-1EP_3x2mm_P0.5mm_EP1.36x1.46mm

Connections:
+3V3: C57.1, R45.1, U10.8 (VCC)
GND: C57.2, U10.4 (VSS)
I2C_SYS_SCL: U10.6 (SCL)
I2C_SYS_SDA: U10.5 (SDA)
NFC_ANT_A: C56.1, J6.1, U10.2 (AC0)
NFC_ANT_B: C56.2, J6.2, U10.3 (AC1)
NFC_FD: R45.2, U10.7 (GPO)

Notes on the sheet:
NFC: ST25DV04K dynamic tag (ISO 15693 / NFC Type 5), I2C on the system bus. The phone is the reader. Chosen over NTAG I2C plus because its symbol is in the reviewed KiCad library; ST25DV04KC is the current revision - confirm pin compatibility. Powered from +3V3 (not switched) so it never loads the 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
