Oxjade/Circuit/kicad/power.kicad_sch

## KiCad design kicad/power.kicad_sch (2026-11-11)

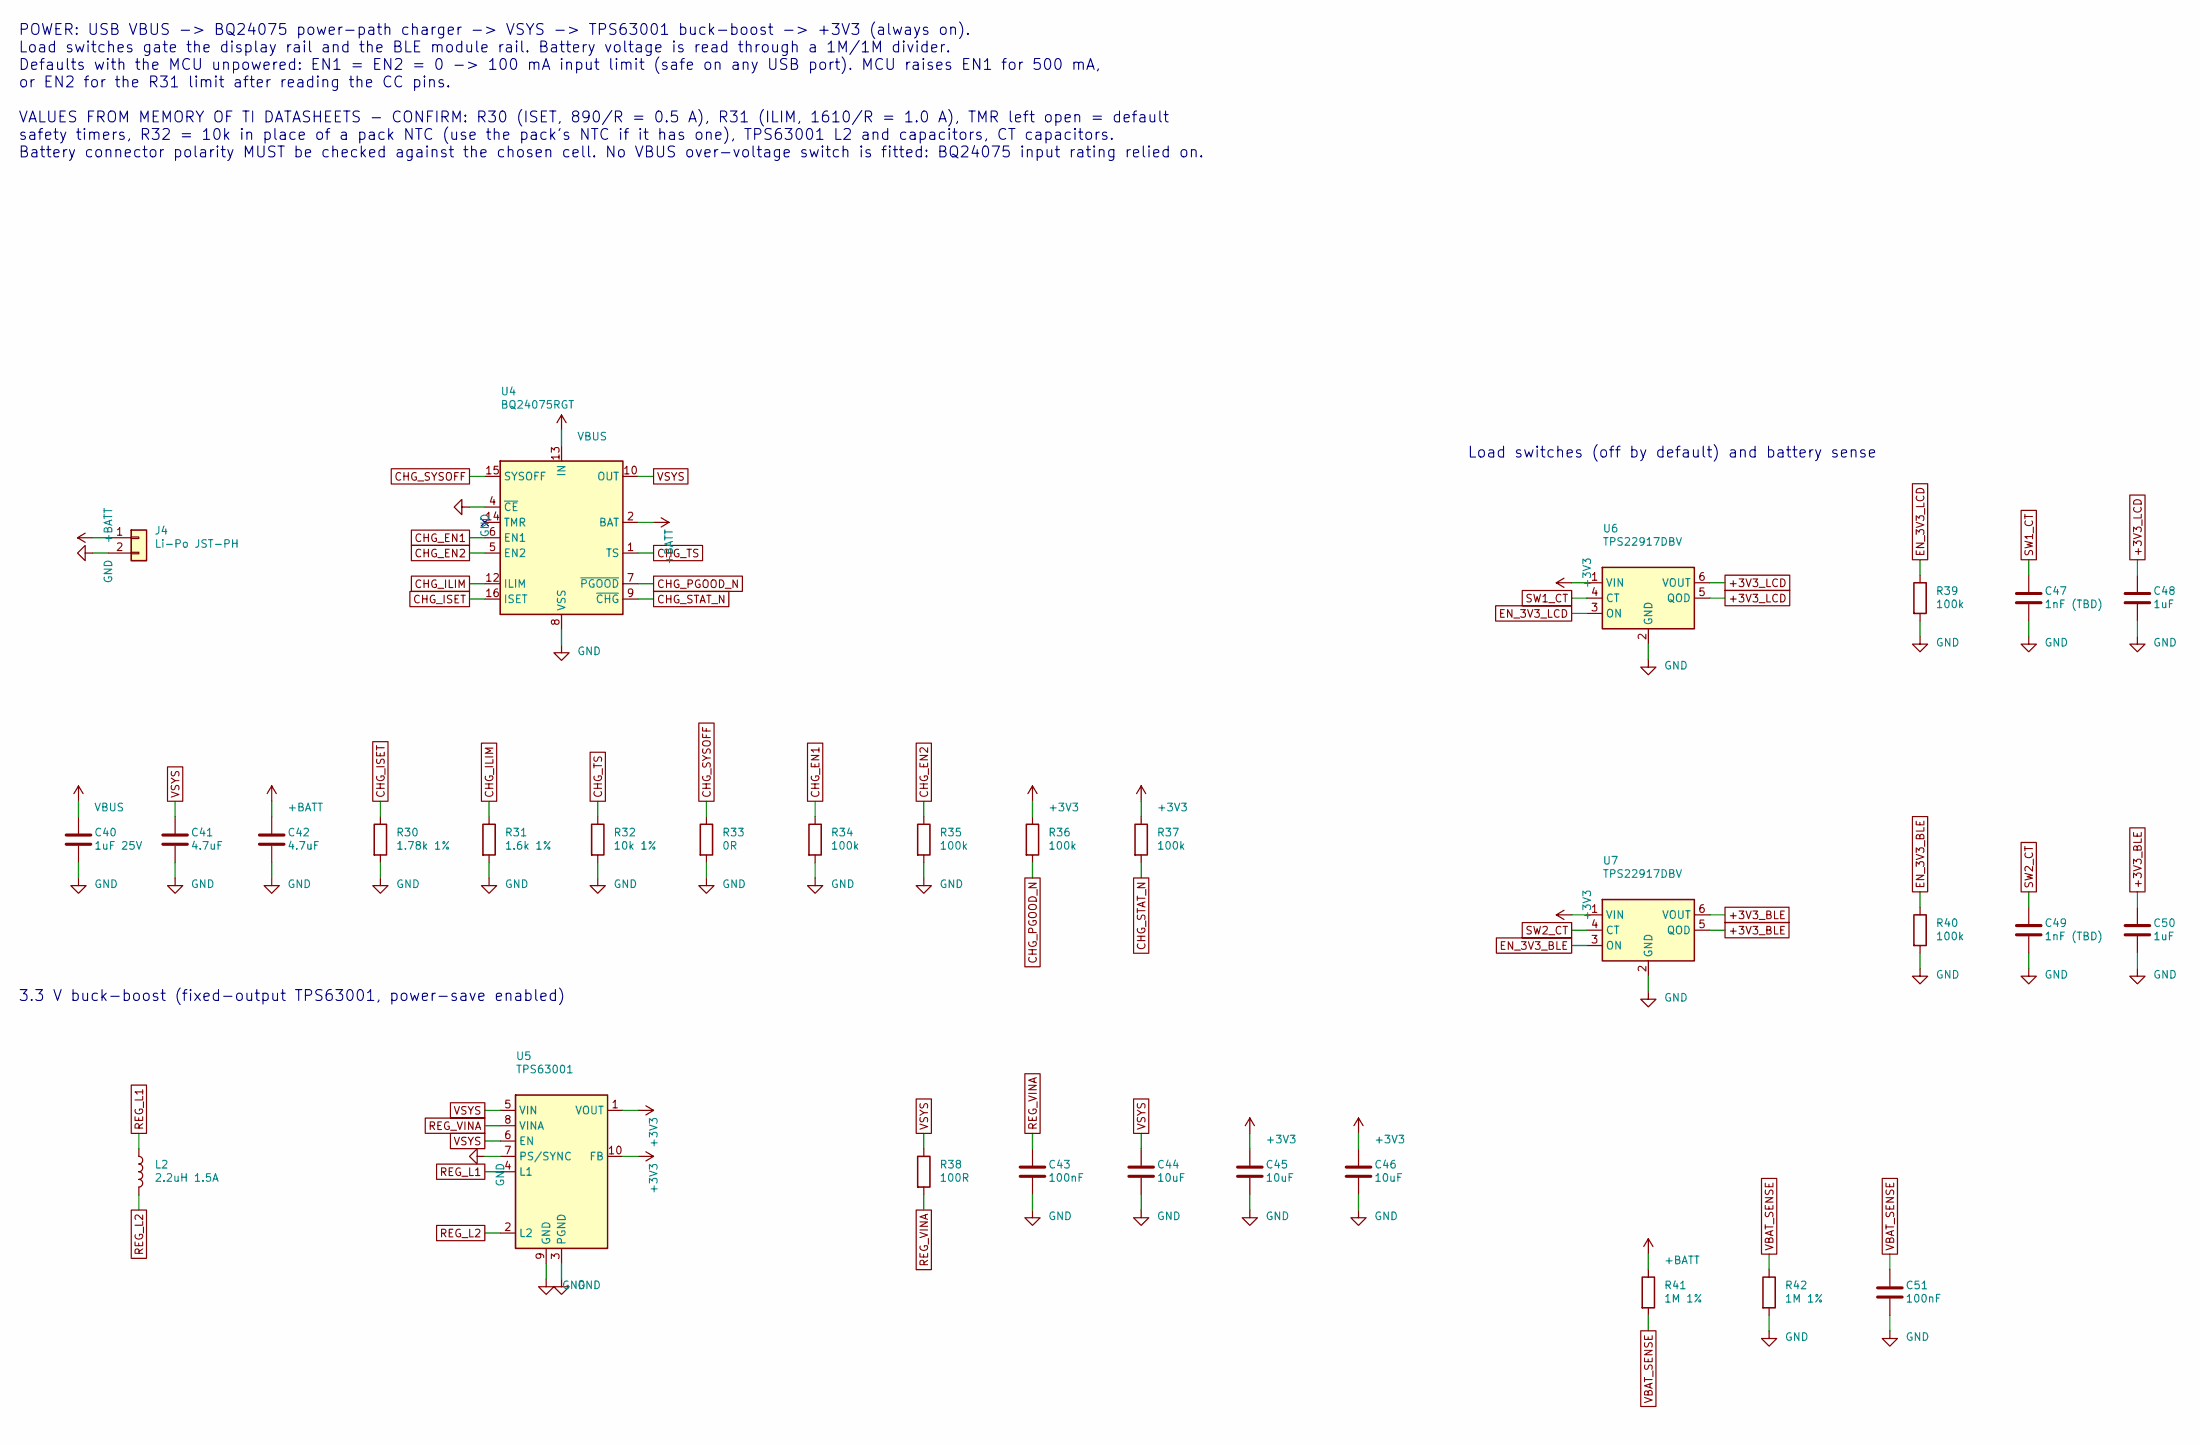
[picture p29: schematic power.kicad_sch]

Parts:
C40: 1uF 25V; C_0603_1608Metric
C41, C42: 4.7uF; C_0603_1608Metric
C43, C51: 100nF; C_0402_1005Metric
C44, C45, C46: 10uF; C_0603_1608Metric
C47, C49: 1nF (TBD); C_0402_1005Metric
C48, C50: 1uF; C_0402_1005Metric
J4: Li-Po JST-PH; JST_PH_S2B-PH-SM4-TB_1x02-1MP_P2.00mm_Horizontal
L2: 2.2uH 1.5A; L_1008_2520Metric
R30: 1.78k 1%; R_0402_1005Metric
R31: 1.6k 1%; R_0402_1005Metric
R32: 10k 1%; R_0402_1005Metric
R33: 0R; R_0402_1005Metric
R34, R35, R36, R37, R39, R40: 100k; R_0402_1005Metric
R38: 100R; R_0402_1005Metric
R41, R42: 1M 1%; R_0402_1005Metric
U4: BQ24075RGT; VQFN-16-1EP_3x3mm_P0.5mm_EP1.6x1.6mm
U5: TPS63001; Texas_DRC0010J_ThermalVias
U6, U7: TPS22917DBV; SOT-23-6

Connections:
+3V3: C45.1, C46.1, R36.1, R37.1, U5.1 (VOUT), U5.10 (FB), U6.1 (VIN), U7.1 (VIN)
+3V3_BLE: C50.1, U7.5 (QOD), U7.6 (VOUT)
+3V3_LCD: C48.1, U6.5 (QOD), U6.6 (VOUT)
+BATT: C42.1, J4.1, R41.1, U4.2 (BAT), U4.3 (BAT)
CHG_EN1: R34.1, U4.6 (EN1)
CHG_EN2: R35.1, U4.5 (EN2)
CHG_ILIM: R31.1, U4.12 (ILIM)
CHG_ISET: R30.1, U4.16 (ISET)
CHG_PGOOD_N: R36.2, U4.7 (~PGOOD)
CHG_STAT_N: R37.2, U4.9 (~CHG)
CHG_SYSOFF: R33.1, U4.15 (SYSOFF)
CHG_TS: R32.1, U4.1 (TS)
EN_3V3_BLE: R40.1, U7.3 (ON)
EN_3V3_LCD: R39.1, U6.3 (ON)
GND: C40.2, C41.2, C42.2, C43.2, C44.2, C45.2, C46.2, C47.2, C48.2, C49.2, C50.2, C51.2, J4.2, R30.2, R31.2, R32.2, R33.2, R34.2, R35.2, R39.2, R40.2, R42.2, U4.4 (~CE), U4.8 (VSS), U4.17 (VSS), U5.3 (PGND), U5.7 (PS/SYNC), U5.9 (GND), U5.11 (PGND), U6.2 (GND), U7.2 (GND)
REG_L1: L2.1, U5.4 (L1)
REG_L2: L2.2, U5.2 (L2)
REG_VINA: C43.1, R38.2, U5.8 (VINA)
SW1_CT: C47.1, U6.4 (CT)
SW2_CT: C49.1, U7.4 (CT)
VBAT_SENSE: C51.1, R41.2, R42.1
VBUS: C40.1, U4.13 (IN)
VSYS: C41.1, C44.1, R38.1, U4.10 (OUT), U4.11 (OUT), U5.5 (VIN), U5.6 (EN)

Notes on the sheet:
POWER: USB VBUS -> BQ24075 power-path charger -> VSYS -> TPS63001 buck-boost -> +3V3 (always on). Load switches gate the display rail and the BLE module rail. Battery voltage is read through a 1M/1M divider. Defaults with the MCU unpowered: EN1 = EN2 = 0 -> 100 mA input limit (safe on any USB port)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
3.3 V buck-boost (fixed-output TPS63001, power-save enabled)
Load switches (off by default) and battery sense
