Oxjade/Circuit/kicad/secure.kicad_sch

## KiCad design kicad/secure.kicad_sch (2026-11-11)

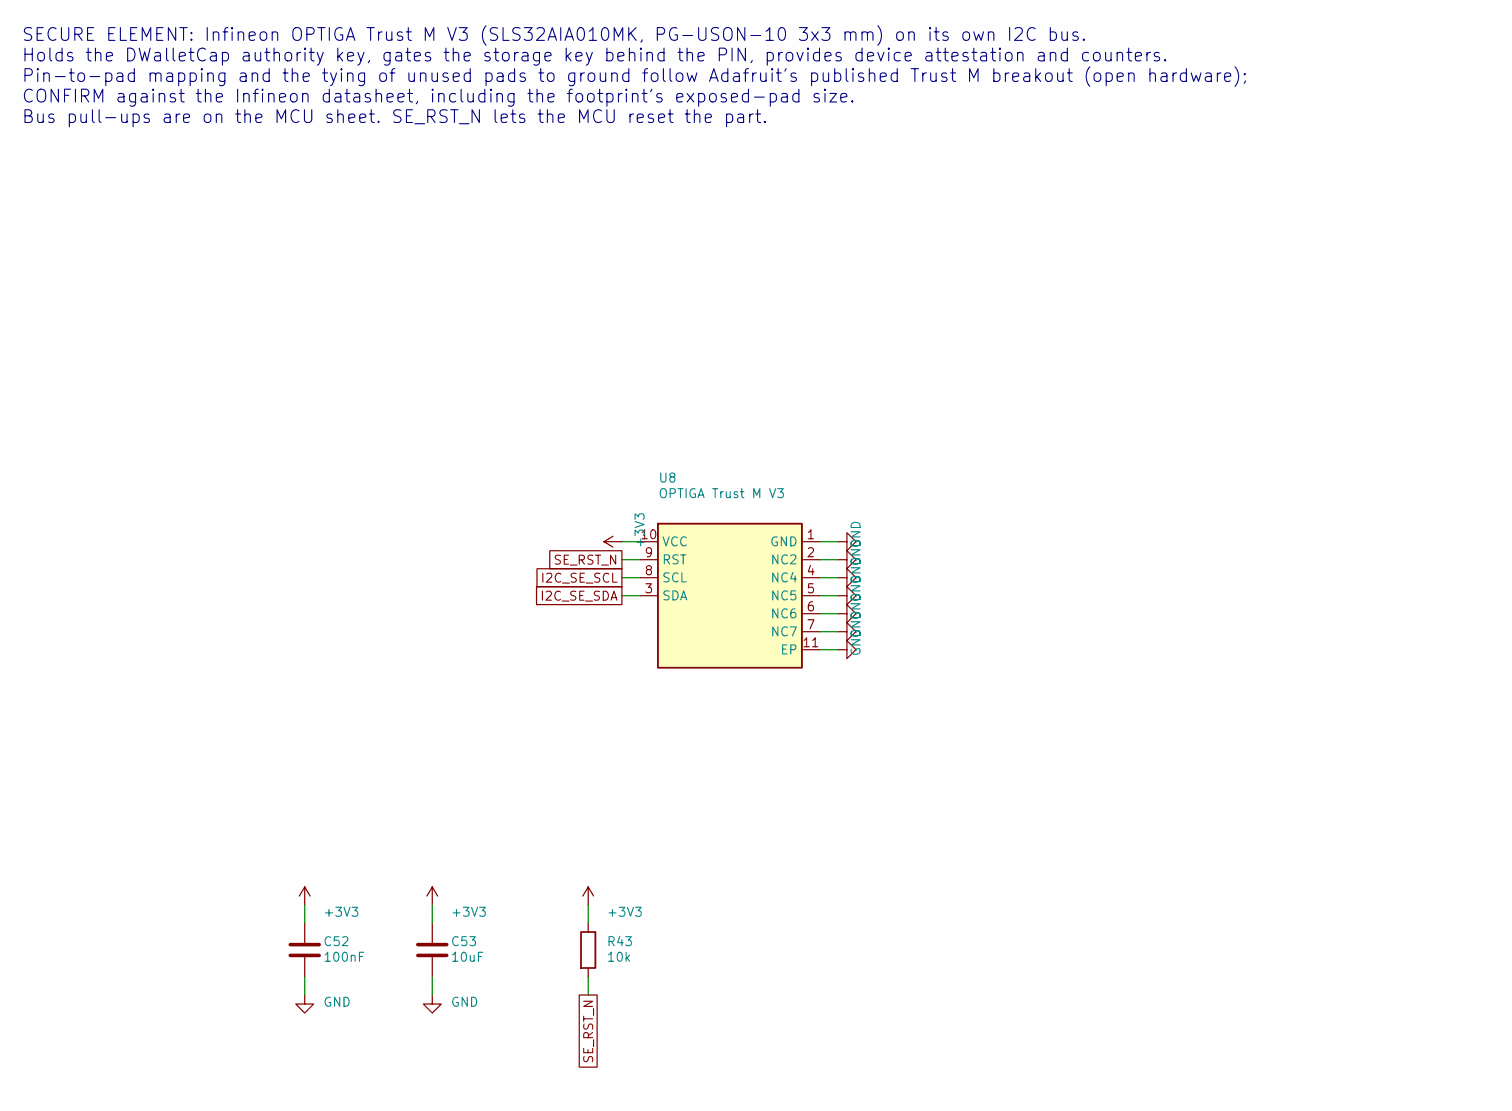
[picture p30: schematic secure.kicad_sch]

Parts:
C52: 100nF; C_0402_1005Metric
C53: 10uF; C_0603_1608Metric
R43: 10k; R_0402_1005Metric
U8: OPTIGA Trust M V3; DFN-10-1EP_3x3mm_P0.5mm_EP1.55x2.48mm

Connections:
+3V3: C52.1, C53.1, R43.1, U8.10 (VCC)
GND: C52.2, C53.2, U8.1 (GND), U8.2 (NC2), U8.4 (NC4), U8.5 (NC5), U8.6 (NC6), U8.7 (NC7), U8.11 (EP)
I2C_SE_SCL: U8.8 (SCL)
I2C_SE_SDA: U8.3 (SDA)
SE_RST_N: R43.2, U8.9 (RST)

Notes on the sheet:
SECURE ELEMENT: Infineon OPTIGA Trust M V3 (SLS32AIA010MK, PG-USON-10 3x3 mm) on its own I2C bus. Holds the DWalletCap authority key, gates the storage key behind the PIN, provides device attestation and counters. Pin-to-pad mapping and the tying of unused pads to ground follow Adafruit's published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
