Oxjade/Circuit/kicad/usb.kicad_sch

## KiCad design kicad/usb.kicad_sch (2026-11-11)

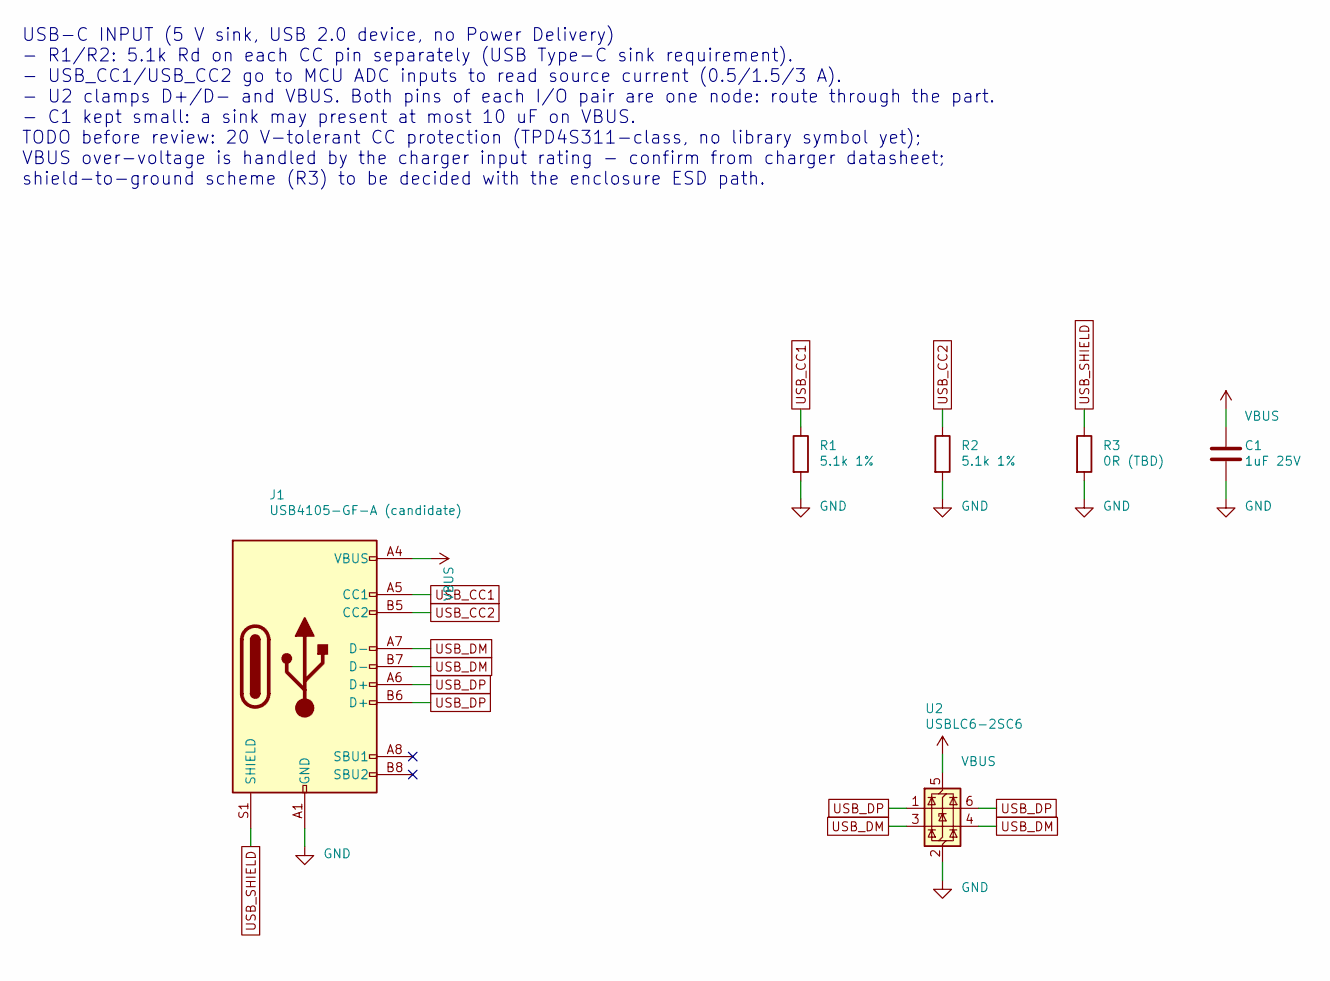
[picture p31: schematic usb.kicad_sch]

Parts:
C1: 1uF 25V; C_0603_1608Metric
J1: USB4105-GF-A (candidate); USB_C_Receptacle_GCT_USB4105-xx-A_16P_TopMnt_Horizontal
R1, R2: 5.1k 1%; R_0402_1005Metric
R3: 0R (TBD); R_0402_1005Metric
U2: USBLC6-2SC6; SOT-23-6

Connections:
GND: C1.2, J1.A1 (GND), J1.A12 (GND), J1.B1 (GND), J1.B12 (GND), R1.2, R2.2, R3.2, U2.2 (GND)
USB_CC1: J1.A5 (CC1), R1.1
USB_CC2: J1.B5 (CC2), R2.1
USB_DM: J1.A7 (D-), J1.B7 (D-), U2.3 (I/O2), U2.4 (I/O2)
USB_DP: J1.A6 (D+), J1.B6 (D+), U2.1 (I/O1), U2.6 (I/O1)
USB_SHIELD: J1.S1 (SHIELD), R3.1
VBUS: C1.1, J1.A4 (VBUS), J1.A9 (VBUS), J1.B4 (VBUS), J1.B9 (VBUS), U2.5 (VBUS)

Notes on the sheet:
USB-C INPUT (5 V sink, USB 2.0 device, no Power Delivery) - R1/R2: 5.1k Rd on each CC pin separately (USB Type-C sink requirement). - USB_CC1/USB_CC2 go to MCU ADC inputs to read source current (0.5/1.5/3 A). - U2 clamps D+/D- and VBUS. Both pins of each I/O pair are one node: route through the par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
