Oxjade/Circuit/(commit log)

2026-11-11 Add Phase 1 hardware architecture and provisional KiCad board definition
    Phase 1 document covers block diagram, component architecture, MCU and
    secure-element comparison, display, connectivity, power, placement
    concept, interface matrix and open risks. KiCad project holds only the
    board outline, layer count, mechanical anchors and a root sheet; no
    schematic capture or routing yet.
    Claude-Session: https://claude.ai/code/session_015wtVTmYAtsuxtbDLp5k2p1
    [circuit.kicad_pcb, circuit.kicad_sch]
2026-11-11 Add draft schematic sheets for USB-C input and haptics, buttons, debug
    Sheets are generated from KiCad library symbols so pinouts are not typed
    by hand; the generator checks connectivity against KiCad's netlist
    export. Passive values are unverified defaults.
    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
    [circuit.kicad_sch, hmi.kicad_sch, usb.kicad_sch]
2026-11-11 Record hybrid architecture decision and add draft MCU schematic sheet
    STM32U5G9NJH6Q with pin map for display, touch, secure element, system
    bus, BLE, USB, buttons, tamper and debug. Pin functions verified against
    the KiCad library's alternate-function data; power-pin network values
    are flagged for datasheet confirmation.
    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
    [circuit.kicad_sch, mcu.kicad_sch]
2026-11-11 Complete draft schematic: power, secure element, BLE, NFC, display sheets
    Adds BQ24075 charger, TPS63001 buck-boost, load switches, OPTIGA Trust M,
    MDBT50Q BLE module, ST25DV04K NFC tag, display and touch connectors with
    TPS61165 backlight driver, and tamper switch positions. 127 parts, 105
    nets, all matching KiCad's netlist export. Display connector pin order is
    a placeholder; values from memory are flagged on each sheet.
    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
    [ble.kicad_sch, bom-draft.csv, circuit.kicad_sch, display.kicad_sch, hmi.kicad_sch, mcu.kicad_sch, nfc.kicad_sch, power.kicad_sch]
2026-11-11 Move all KiCad files into a single kicad folder
    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
    [ble.kicad_sch, bom-draft.csv, circuit.kicad_pcb, circuit.kicad_sch, display.kicad_sch, hmi.kicad_sch, mcu.kicad_sch, nfc.kicad_sch]
2026-11-11 Add first-pass FreeCAD mechanical model
    Parametric script builds housing, rear cover, PCB, battery, display stack
    and component placeholders, runs an interference check, and exports
    FCStd, STEP, STL and renders. Processor moved on the board to clear the
    confirm switch.
    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
    [button_confirm.stl, button_power.stl, circuit-assembly.step, circuit.FCStd, circuit.kicad_pcb, front_housing.stl, rear_cover.stl]
